frenchmakers/vauban3d-xl/1420-14 Accesoire/2013_08_Men-at-Lunch-1.jpg

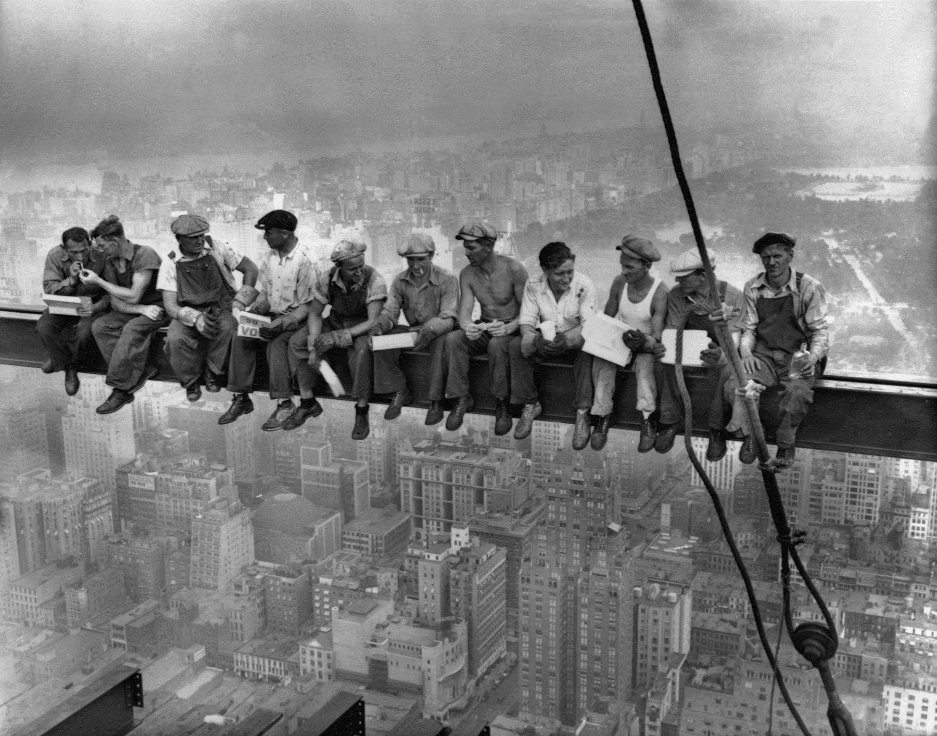
1420-14 Accesoire/2013_08_Men-at-Lunch-1.jpg
