frenchmakers/vauban3d-xl/README.md

# vauban3d-xl
Imprimante 3D Vauban 3D XL
