frenchmakers/vauban3d-xl/1420-91 Gabarits/frenchmakers_noir_blanc.png

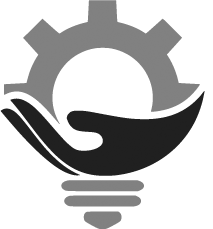
1420-91 Gabarits/frenchmakers_noir_blanc.png
