frenchmakers/vauban3d-xl/Rendu/1420-00 Vauban 3D XL_fond_noir.png

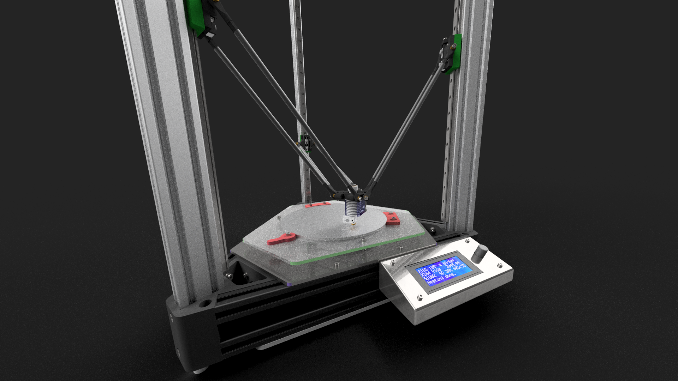
Rendu/1420-00 Vauban 3D XL_fond_noir.png
