frenchmakers/vauban3d-xl/Rendu/1420-00-00 Vauban 3D XL9.png

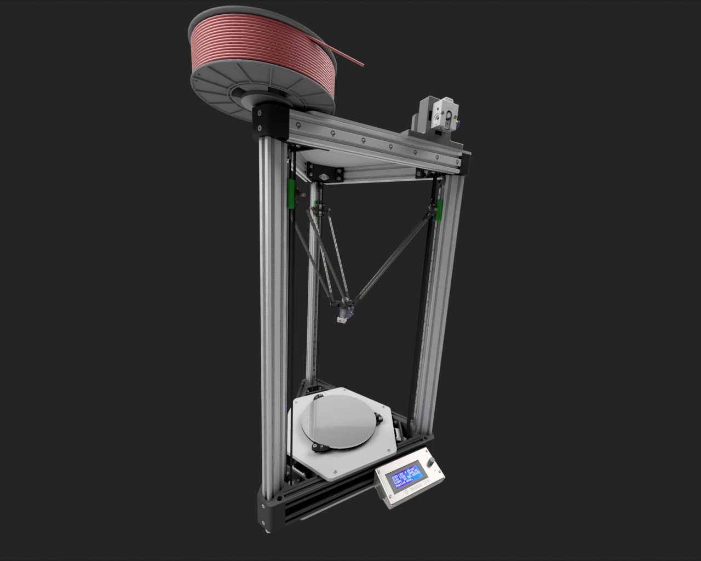
Rendu/1420-00-00 Vauban 3D XL9.png
