frenchmakers/vauban3d-xl/1420-01 Armature/Nomenclature.xlsx

ARTICLE | QTE | NUMERO DE PIECE | MATIERE
 | 85 | ANSI B18.3.1M - M3x0,5 x 8 | ----------
 | 48 | DIN 125 - A 5,3 | ----------
 | 48 | ANSI B18.3.1M - M5x0,8 x 12 | ----------
 | 6 | ANSI B18.3.1M - M5x0,8 x 25 | ----------
 | 12 | DIN 7991 - M4x10 | ----------
 | 49 | ANSI B18.3.1M - M3x0,5 x 10 | ----------
 | 18 | DIN 125 - A 3,2 | ----------
 | 1 | ANSI B18.3.1M - M5x0,8 x 30 | ----------
 | 3 | ANSI B18.3.1M - M3x0,5 x 30 | ----------
 | 9 | ISO 7380-1 - M3 x 8 | ----------
 | 7 | DIN 934 - M3 | ----------
 | 4 | ANSI B18.3.1M - M3x0,5 x 16 | ----------
 | 4 | ANSI B18.3.1M - M3x0,5 x 20 | ----------
 | 2 | ANSI B18.3.1M - M5x0,8 x 20 | ----------
 | 6 | DIN 963 - M3 x 8 | ----------
 | 6 | DIN 7985 (H) - M3x12-H | ----------
 | 2 | ANSI B18.3.1M - M3x0,5 x 6 | ----------
 | 1 | DIN 985 - M3 | ----------
1420-01-01 | 3 | Profile vertical 20x40x750 | Aluminium
1420-01-02 | 3 | Profile horizontal 20x40x360 | Aluminium
1420-01-03 | 6 | Profile horizontal 20x20x360 | Aluminium
1420-01-09 | 3 | Pied | Aluminium
1420-01-11 | 95 | Noix M3 | Aluminium
1420-01-12 | 12 | Noix M4 | Aluminium
1420-01-13 | 48 | Noix M5 | Aluminium
1420-01-05 | 3 | Coins inferieur | Aluminium
1420-01-15 | 3 | Coins superieur | Aluminium
1420-02-01 | 1 | Efflector | Aluminium
1420-02-02 | 1 | Support ventillateur E3D | Plastique ABS
1420-02-03 | 1 | Plaque superieur | Plastique PMMA
1420-02-03 | 1 | Ventilateur 30x30x10 | ----------
1420-02-04 | 6 | Rotule | Laiton, jaune doux
1420-02-20 | 1 | Buse E3D V6 | ----------
1420-03-01 | 1 | Entretoise | Plastique ABS
1420-03-02 | 1 | Support | Plastique ABS
1420-03-03 | 1 | Adapteur | Plastique ABS
1420-03-04 | 1 | Roulement a bille 608ZZ | Acier inoxydable
1420-04-01 | 1 | Plateau metalique | Aluminium
1420-04-02 | 1 | Plateau verre D200 | Miroir
1420-04-02 | 1 | Plexiglass | Plastique PMMA
1420-04-04 | 2 | Bloque plateau | Plastique ABS
1420-04-04 | 1 | Came | Plastique ABS
1420-04-06 | 3 | Ressort | Acier
1420-05-01 | 1 | Support moteur | Plastique ABS
1420-06-01 | 3 | Support capteur | Plastique ABS
1420-06-02 | 3 | Endstop | ----------
1420-07-01 | 1 | Plaque bas | Plastique PMMA
1420-07-02 | 3 | Support carte electronique | Plastique ABS
1420-08-01 | 1 | Boitier | Aluminium
1420-08-02 | 1 | Ecran LCD | ----------
1420-09-01 | 1 | Plug alimentation | ----------
1420-09-02 | 1 | Prise USB | ----------
1420-09-03 | 1 | Ecrou plug alimentation | ----------
1420-09-04 | 1 | Support connectique | Plastique ABS
1420-10-01 | 6 | Bras | Carbonne
1420-10-02 | 12 | Support rotule | Plastique ABS
1420-10-03 | 6 | Rotule avec meplat | Laiton, jaune doux
1420-11-10 | 1 | Arduino MEGA2650 | ----------
1420-11-20 | 1 | Ramps 1.4 | ----------
1420-11-40 | 4 | Stepper driver | ----------
1420-11-40 | 3 | Moteur Nema 17 | ----------
1420-12-01 | 3 | Rail | Acier
1420-12-02 | 3 | Cage à bille | ----------
1420-12-04 | 3 | Platine | Aluminium
1420-12-05 | 6 | Tendeur | Aluminium
1420-12-06 | 6 | Contre rondelle | Aluminium
1420-20-03 | 3 | Courroie synchrone | Caoutchouc
1720-14-02 | 1 | Bobine | Plastique ABS
1420-05-10 | 1 | Bulldog Feeder | ----------
1420-01-10 | 3 | Poulie | Aluminium
