frenchmakers/vauban3d-xl/1420-01 Armature/Logo_fablab.stp

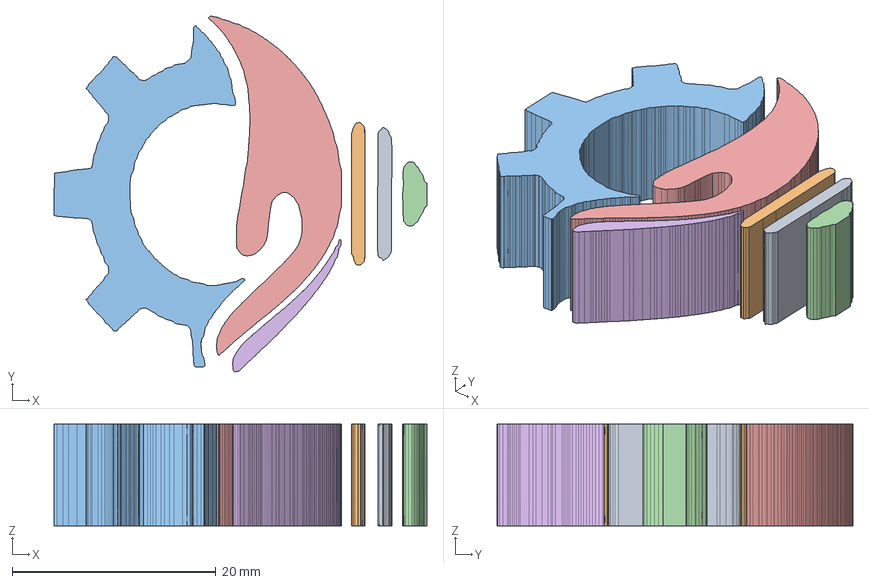
[picture p7: CAD file, 2017-04-20]
1420-01 Armature/Logo_fablab.stp
36.7 x 35.0 x 10.0 mm
