frenchmakers/vauban3d-xl/1420-02 Tete/1420-02-00 Tete.stp

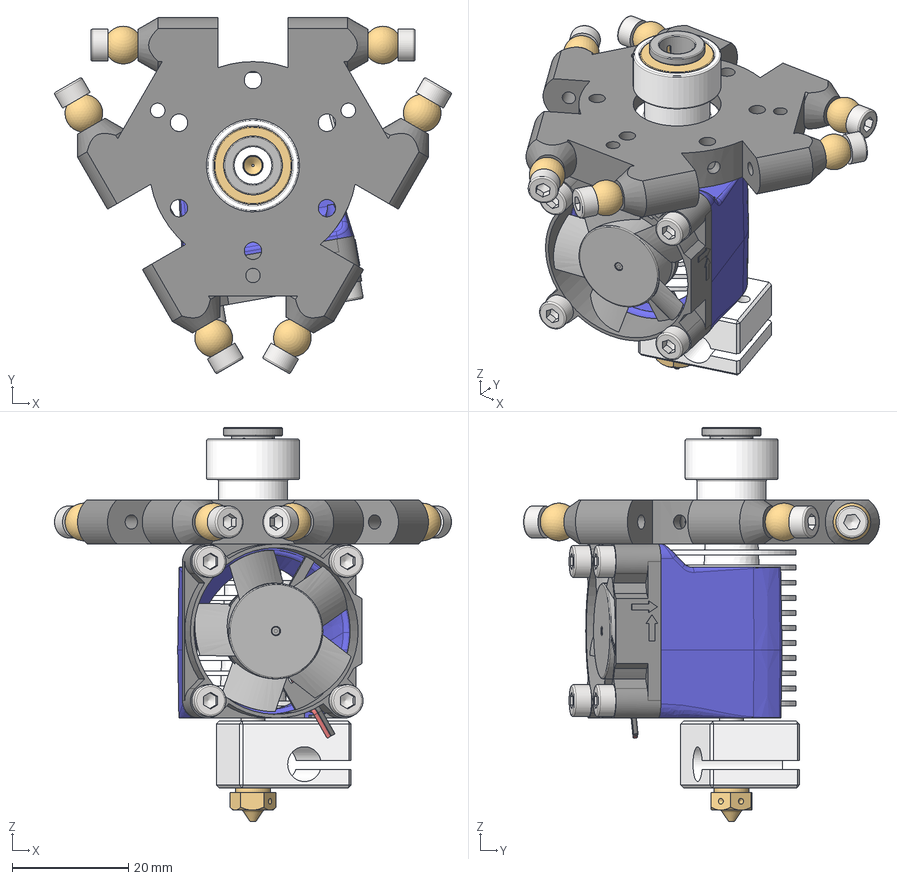
[picture p8: CAD file, 2017-04-20]
1420-02 Tete/1420-02-00 Tete.stp
68.4 x 61.3 x 68.0 mm
Base
Vis
bloque_chauffe
Buse_04
Bague-laiton
clip
Efflector
ANSI B18.3.1M - M3x0,5 x 10 x 10
Rotule x 6
Support ventillateur E3D
Ventilateur 30x30x10
