frenchmakers/vauban3d-xl/1420-13 Layer fan/Support_layer_fan.stl

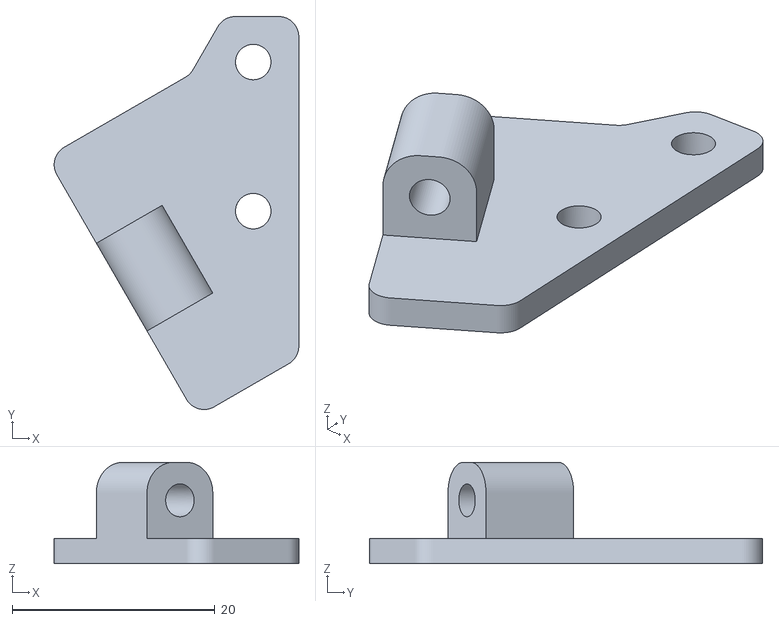
[picture p9: CAD file, 2017-04-20]
1420-13 Layer fan/Support_layer_fan.stl
24.2 x 38.8 x 10.0
