frenchmakers/vauban3d-xl/1420-50 Plateau pour cura/1420-50-01 Plateau pour cura.stl

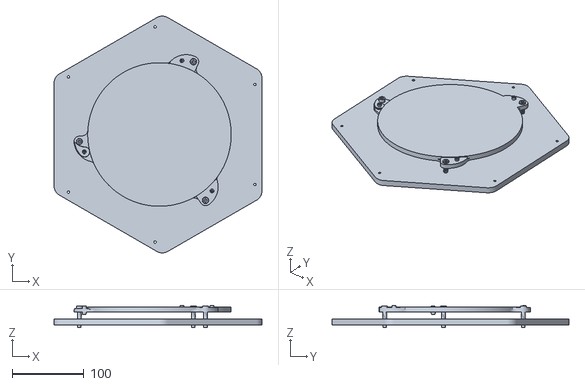
[picture p10: CAD file, 2017-04-20]
1420-50 Plateau pour cura/1420-50-01 Plateau pour cura.stl
289.9 x 330.1 x 31.1
