frenchmakers/vauban3d-xl/Piece imprime/1420-06-01 Support capteur.stl

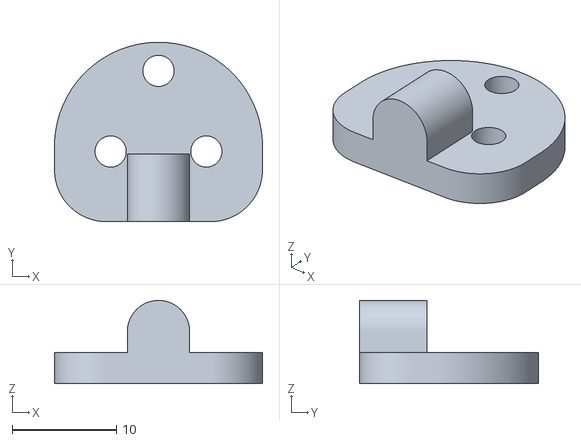
[picture p11: CAD file, 2017-04-20]
Piece imprime/1420-06-01 Support capteur.stl
20.0 x 17.2 x 8.00
