frenchmakers/vauban3d-xl/1420-13 Layer fan/Support_ventillateur.stl

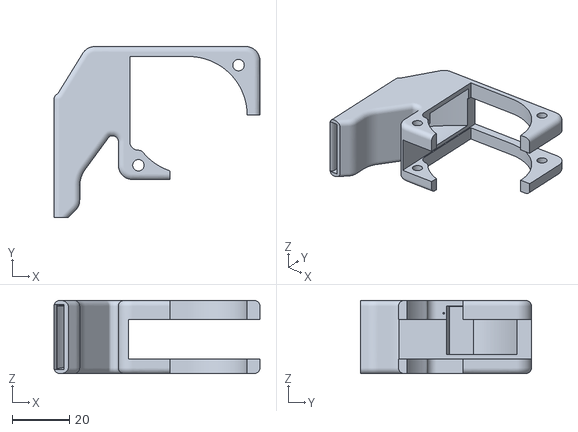
[picture p12: CAD file, 2017-04-20]
1420-13 Layer fan/Support_ventillateur.stl
72.0 x 59.8 x 25.6
