frenchmakers/vauban3d-xl/Piece imprime/1420-03-03 Adapteur.stl

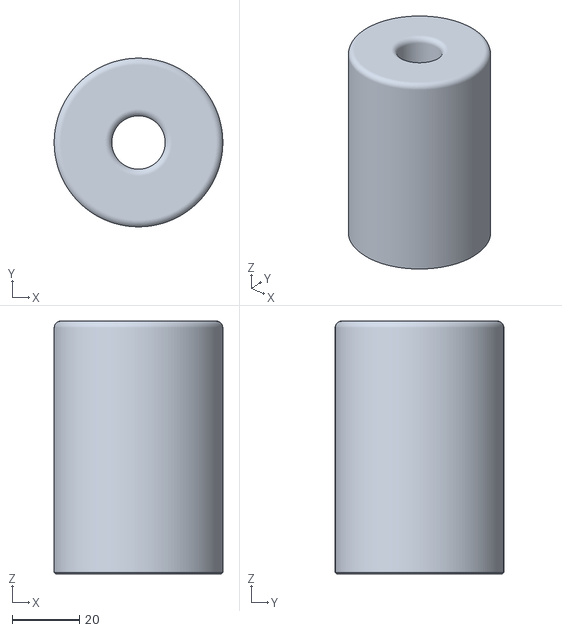
[picture p13: CAD file, 2017-04-20]
Piece imprime/1420-03-03 Adapteur.stl
50.0 x 50.0 x 75.0
