frenchmakers/vauban3d-xl/1420-13 Layer fan/bras_layer_fan.stl

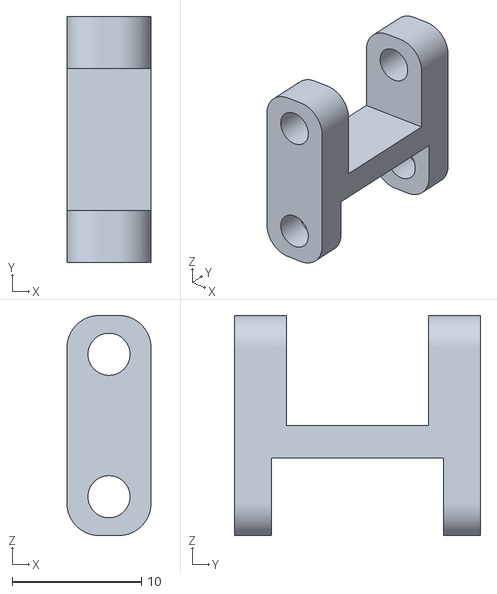
[picture p14: CAD file, 2017-04-20]
1420-13 Layer fan/bras_layer_fan.stl
6.50 x 19.0 x 17.0
