frenchmakers/vauban3d-xl/Piece imprime/1420-05-01 Support moteur.stl

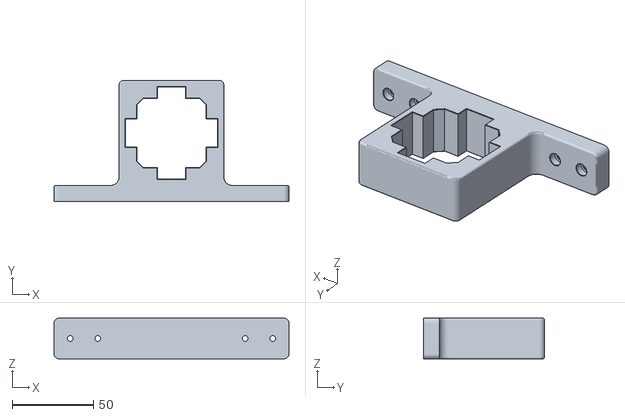
[picture p15: CAD file, 2017-04-20]
Piece imprime/1420-05-01 Support moteur.stl
144.6 x 74.6 x 25.0
