frenchmakers/vauban3d-xl/Piece imprime/1420-03-02 Support.stl

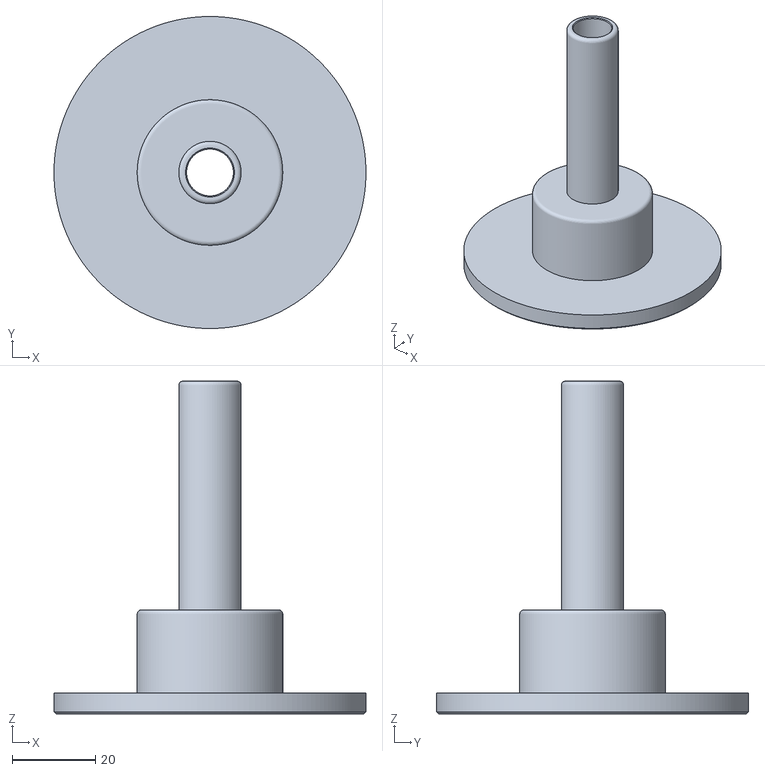
[picture p16: CAD file, 2017-04-20]
Piece imprime/1420-03-02 Support.stl
75.0 x 75.0 x 80.0
