frenchmakers/vauban3d-xl/Piece imprime/1420-07-02 Support carte electronique.stl

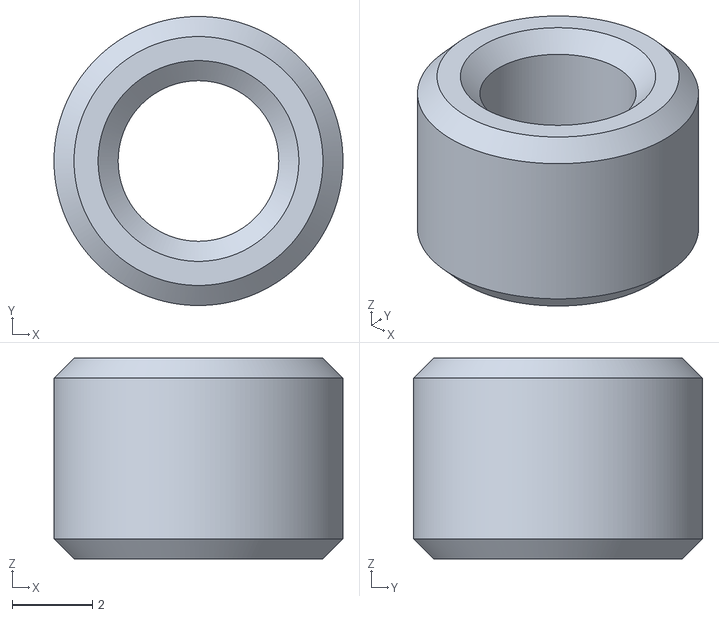
[picture p17: CAD file, 2017-04-20]
Piece imprime/1420-07-02 Support carte electronique.stl
7.20 x 7.20 x 5.00
