frenchmakers/vauban3d-xl/Piece imprime/1420-03-01 Entretoise.stl

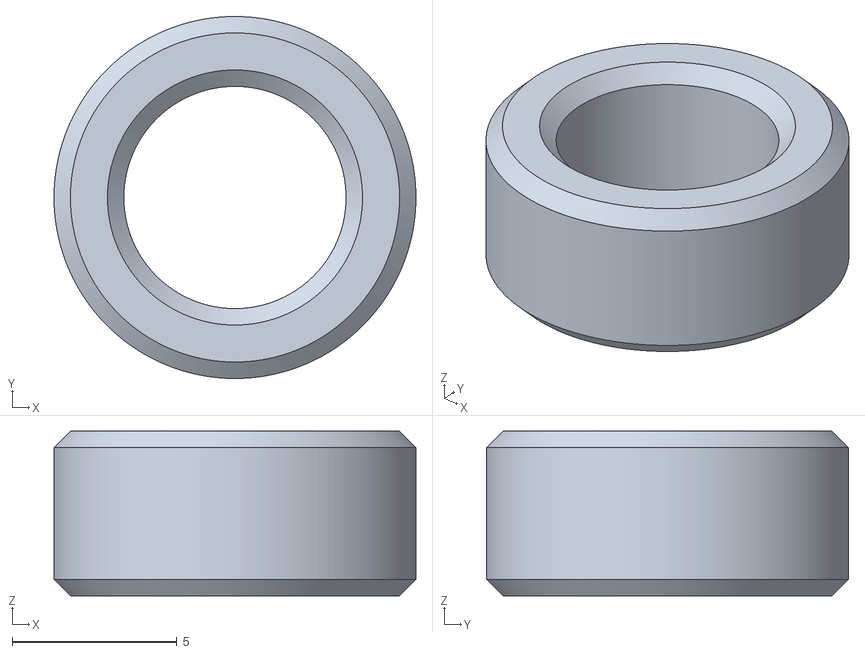
[picture p18: CAD file, 2017-04-20]
Piece imprime/1420-03-01 Entretoise.stl
11.0 x 11.0 x 5.00
