frenchmakers/vauban3d-xl/(list of files, cad)

Other CAD files:
1420 Notice de montage/1420 Vauban 3D XL Nomenclature.idw
1420 Notice de montage/1420-50 Armature/1420-50 Armature.ipn
1420 Notice de montage/1420-50 Armature/1420-50-01 Coins inferieur.ipn
1420 Notice de montage/1420-50 Armature/1420-50-02 Coins superieur.ipn
1420 Notice de montage/1420-52 Electronique/1420-52-00 Electronique.ipn
1420 Notice de montage/1420-53 Guidage/1420-53 Guidage.ipn
1420 Notice de montage/1420-53 Guidage/1420-53-01 Tendeur.ipn
1420 Notice de montage/1420-54 Plateau/1420-54 Plateau.ipn
1420 Notice de montage/1420-55 Tete/1420-55 Tete.idw
1420 Notice de montage/1420-55 Tete/1420-55 tete.ipn
1420 Notice de montage/1420-55 Tete/1420-55-01 Bras.ipn
1420 Notice de montage/1420-57 Finition/1420-57 Finition.ipn
1420-01 Armature/1420-01-00 Armature.iam
1420-01 Armature/1420-01-01 Profile vertical 20x40x750.ipt
1420-01 Armature/1420-01-02 Profile horizontal 20x40x360.ipt
1420-01 Armature/1420-01-03 Profile horizontal 20x20x360.ipt
1420-01 Armature/1420-01-04 Coins superieur.ipt
1420-01 Armature/1420-01-05 Coins inferieur.ipt
1420-01 Armature/1420-01-06 Roulement a bille F623ZZ.ipt
1420-01 Armature/1420-01-07 Axe de renvoie.ipt
1420-01 Armature/1420-01-08 Maintient roulement.ipt
1420-01 Armature/1420-01-09 Pied.ipt
1420-01 Armature/1420-01-10 Poulie.ipt
1420-01 Armature/1420-01-11 Noix M3.ipt
1420-01 Armature/1420-01-12 Noix M4.ipt
1420-01 Armature/1420-01-13 Noix M5.ipt
1420-01 Armature/1420-01-14 Coins inferieur.iam
1420-01 Armature/1420-01-15 Coins superieur.iam
1420-02 Tete/1420-02-00 Tete.iam
1420-02 Tete/1420-02-01 Efflector.ipt
1420-02 Tete/1420-02-02 Support ventillateur E3D.ipt
1420-02 Tete/1420-02-03 Ventilateur 30x30.ipt
1420-02 Tete/1420-02-04 Rotule.ipt
1420-02 Tete/Buse_E3D_V6/1420-02-20 Buse E3d V6.iam
1420-02 Tete/Buse_E3D_V6/1420-02-21 Buse 04.ipt
1420-02 Tete/Buse_E3D_V6/1420-02-22 Bloque de chauffe.ipt
1420-02 Tete/Buse_E3D_V6/1420-02-23 Vis de raccord.ipt
1420-02 Tete/Buse_E3D_V6/1420-02-24 Base.ipt
1420-02 Tete/Buse_E3D_V6/1420-02-25 Bague.ipt
1420-02 Tete/Buse_E3D_V6/1420-02-26 Clip pneumatique.ipt
1420-03 Support bobine filament/1420-03-00 Support bobine.iam
1420-03 Support bobine filament/1420-03-01 Entretoise.ipt
1420-03 Support bobine filament/1420-03-02 Support.ipt
1420-03 Support bobine filament/1420-03-03 Adapteur.ipt
1420-03 Support bobine filament/1420-03-04 Roulement a bille 608ZZ.ipt
1420-04 Plateau/1420-04-00 Plateau.iam
1420-04 Plateau/1420-04-01 Plateau metalique.ipt
1420-04 Plateau/1420-04-02 Plexiglass.ipt
1420-04 Plateau/1420-04-03 Plateau verre D200.ipt
1420-04 Plateau/1420-04-04 Bloque plateau.ipt
1420-04 Plateau/1420-04-04 Came.ipt
1420-04 Plateau/1420-04-06 Ressort.ipt
1420-05 Feeder/1420-05-01 Support moteur.ipt
1420-05 Feeder/1420-05-10 Bulldog feeder.iam
1420-05 Feeder/1420-05-10 Feeder.iam
1420-05 Feeder/1420-05-11 Reducteur.ipt
1420-05 Feeder/1420-05-12 Cache reducteur.ipt
1420-05 Feeder/1420-05-13 Roue dente.ipt
1420-05 Feeder/1420-05-14 Support coulisse.ipt
1420-05 Feeder/1420-05-15 Coulisse.ipt
1420-05 Feeder/1420-05-16 Plaque de maintient.ipt
1420-05 Feeder/1420-05-17 Roulement a bille 634ZZ.ipt
1420-05 Feeder/1420-05-18 Ressort.ipt
1420-05 Feeder/1420-05-19 Clip pneumatique.ipt
1420-05 Feeder/1420-05-20 Nema 17 H30.ipt
1420-05 Feeder/1420-05-21 M5 pour ressort.ipt
1420-06 Endstop/1420-06-00 Endstop.iam
1420-06 Endstop/1420-06-01 Support capteur.ipt
1420-06 Endstop/1420-06-02 Endstop.ipt
1420-07 Plaque/1420-07-01 Plaque inferieur.ipt
1420-07 Plaque/1420-07-02 Support carte electronique.ipt
1420-08 Ecran/1420-08-00 Ecran.iam
1420-08 Ecran/1420-08-01 Boitier tole.ipt
1420-08 Ecran/1420-08-02 Ecran LCD.ipt
1420-08 Ecran/1420-08-03 Carte SD.ipt
1420-09 Connectique/1420-09-00 Connectique.iam
1420-09 Connectique/1420-09-01 Plug alimentation.ipt
1420-09 Connectique/1420-09-02 Prise USB.ipt
1420-09 Connectique/1420-09-03 Ecrou plug alimentation.ipt
1420-09 Connectique/1420-09-04 Support connectique.ipt
1420-09 Connectique/1420-09-10 Bouton/1420-09-03 Bouton.iam
1420-09 Connectique/1420-09-10 Bouton/Base.ipt
1420-09 Connectique/1420-09-10 Bouton/InteriorSw.ipt
1420-09 Connectique/1420-09-10 Bouton/Pieza2.ipt
1420-09 Connectique/1420-09-10 Bouton/Polo2.ipt
1420-09 Connectique/1420-09-10 Bouton/Sw.ipt
1420-10 Bras/1420-10-00 Bras.iam
1420-10 Bras/1420-10-01 Bras.ipt
1420-10 Bras/1420-10-02 Support rotule.ipt
1420-10 Bras/1420-10-03 Rotule avec meplat.ipt
1420-10 Bras/1420-10-04 Rotule simple.ipt
1420-11 Electronique/1420-11-01 Nema 17/1420-11-40 Nema 17.iam
1420-11 Electronique/1420-11-01 Nema 17/1420-11-41 Base.ipt
1420-11 Electronique/1420-11-01 Nema 17/1420-11-42 Body.ipt
1420-11 Electronique/1420-11-01 Nema 17/1420-11-43 Top.ipt
1420-11 Electronique/1420-11-01 Nema 17/1420-11-44 Shaft.ipt
1420-11 Electronique/1420-11-10 Arduino/10 PORT HEADER.ipt
1420-11 Electronique/1420-11-10 Arduino/102 RESISTOR PACK.ipt
1420-11 Electronique/1420-11-10 Arduino/103 RESISTOR PACK.ipt
1420-11 Electronique/1420-11-10 Arduino/1420-11-10 Arduino Mega.iam
1420-11 Electronique/1420-11-10 Arduino/16mhz crystal - measured.ipt
1420-11 Electronique/1420-11-10 Arduino/18 X 2 ROW HEADER.ipt
1420-11 Electronique/1420-11-10 Arduino/220 RESISTOR PACK.ipt
1420-11 Electronique/1420-11-10 Arduino/2pin_header__02.ipt
1420-11 Electronique/1420-11-10 Arduino/47uf CAP Dcase.ipt
1420-11 Electronique/1420-11-10 Arduino/603 cap on pad.ipt
1420-11 Electronique/1420-11-10 Arduino/603 resistor.ipt
1420-11 Electronique/1420-11-10 Arduino/8 PORT HEADER.ipt
1420-11 Electronique/1420-11-10 Arduino/MEGAboard.ipt
1420-11 Electronique/1420-11-10 Arduino/MLC0603.ipt
1420-11 Electronique/1420-11-10 Arduino/PADS001.ipt
1420-11 Electronique/1420-11-10 Arduino/RESET BUTTON.iam
1420-11 Electronique/1420-11-10 Arduino/RESET CORE.ipt
1420-11 Electronique/1420-11-10 Arduino/RESET.ipt
1420-11 Electronique/1420-11-10 Arduino/USB SHELL.ipt
1420-11 Electronique/1420-11-10 Arduino/USB core.ipt
1420-11 Electronique/1420-11-10 Arduino/USB type b.SLDPRT.iam
1420-11 Electronique/1420-11-10 Arduino/atmega16u2.ipt
1420-11 Electronique/1420-11-10 Arduino/atmega2650-16AU.ipt
1420-11 Electronique/1420-11-10 Arduino/blm21.ipt
1420-11 Electronique/1420-11-10 Arduino/cd1206 diode.ipt
1420-11 Electronique/1420-11-10 Arduino/crystal.ipt
1420-11 Electronique/1420-11-10 Arduino/led.ipt
1420-11 Electronique/1420-11-10 Arduino/lmv358.ipt
1420-11 Electronique/1420-11-10 Arduino/lp2985dgkr.ipt
1420-11 Electronique/1420-11-10 Arduino/m7 diode.ipt
1420-11 Electronique/1420-11-10 Arduino/mf-msmf050-2.ipt
1420-11 Electronique/1420-11-10 Arduino/power jack.ipt
1420-11 Electronique/1420-11-10 Arduino/reg.ipt
1420-11 Electronique/1420-11-10 Arduino/ssot3.ipt
1420-11 Electronique/1420-11-10 Arduino/usb btm contact.ipt
1420-11 Electronique/1420-11-10 Arduino/usb top contact.ipt
1420-11 Electronique/1420-11-20 Ramps/1420-11-20 Ramps 1.4.iam
1420-11 Electronique/1420-11-20 Ramps/RAMPS1_4.ipt
1420-11 Electronique/1420-11-20 Ramps/User Library-APA3010GCCK_GREEN.ipt
1420-11 Electronique/1420-11-20 Ramps/User Library-APA3010GCCK_RED.ipt
1420-11 Electronique/1420-11-20 Ramps/User Library-CAPSMD4x3_9.iam
1420-11 Electronique/1420-11-20 Ramps/User Library-CAPSMD4x3_9_CAPSMD4x3_9.ipt
1420-11 Electronique/1420-11-20 Ramps/User Library-CAPSMD4x3_9_CAPSMD4x3_9001.ipt
1420-11 Electronique/1420-11-20 Ramps/User Library-CAPSMD4x3_9_CAPSMD4x3_9002.ipt
1420-11 Electronique/1420-11-20 Ramps/User Library-CAPSMD4x3_9_CAPSMD4x3_9003.ipt
1420-11 Electronique/1420-11-20 Ramps/User Library-CAPSMD4x3_9_CAPSMD4x3_9004.ipt
1420-11 Electronique/1420-11-20 Ramps/User Library-CAPSMD6_3x3_9.iam
1420-11 Electronique/1420-11-20 Ramps/User Library-CAPSMD6_3x3_9_CAP.ipt
1420-11 Electronique/1420-11-20 Ramps/User Library-CAPSMD6_3x3_9_CAP001.ipt
1420-11 Electronique/1420-11-20 Ramps/User Library-CAPSMD6_3x3_9_CAP002.ipt
1420-11 Electronique/1420-11-20 Ramps/User Library-CAPSMD6_3x3_9_CAP003.ipt
1420-11 Electronique/1420-11-20 Ramps/User Library-CAPSMD6_3x3_9_CAP004.ipt
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
