frenchmakers/vauban3d-xl/1420 Notice de montage/1420-53 Guidage/1420-53-00 Guidage.pdf

A ( 1 : 1 )

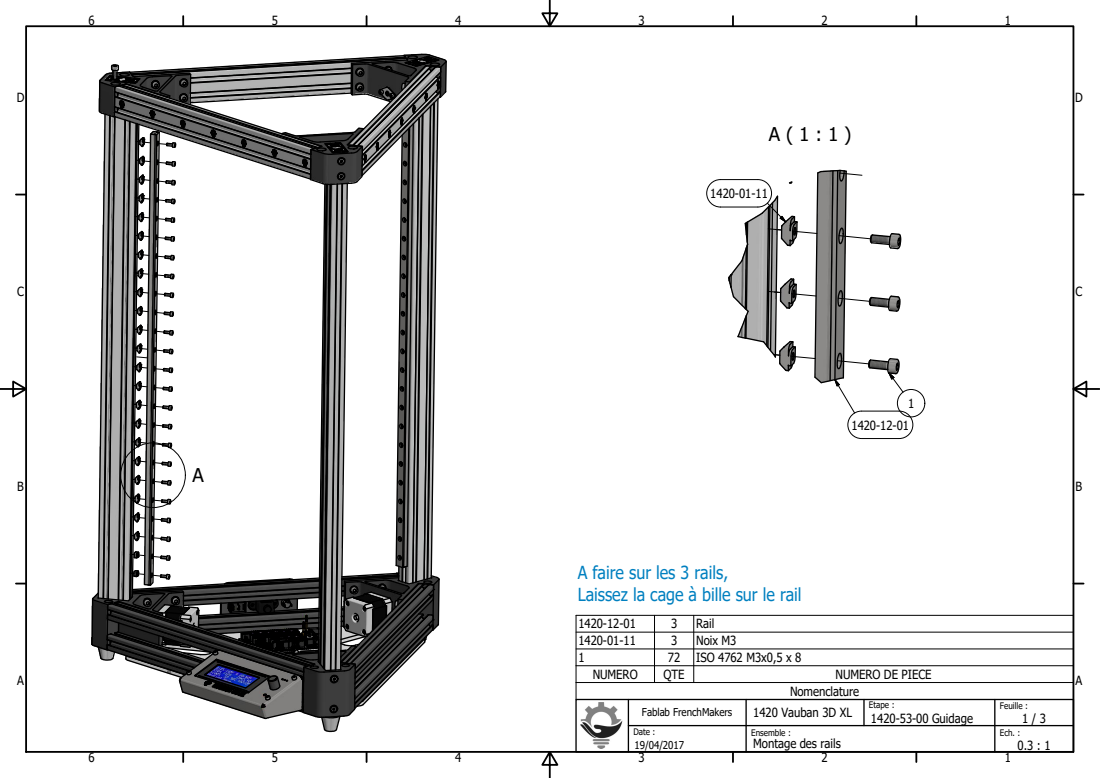
[picture p19: page 1]
Rail; Noix M3; ISO 4762 M3x0,5 x 8; Nomenclature; NUMERO; QTE; NUMERO DE PIECE; 1420 Vauban 3D XL; Ech. : 0.3 : 1; Feuille :; Fablab FrenchMakers; Date :; Etape : 1420-53-00 Guidage

A faire sur les 3 rails,
Laissez la cage j bille sur le rail

Ensemble :
Montage des rails

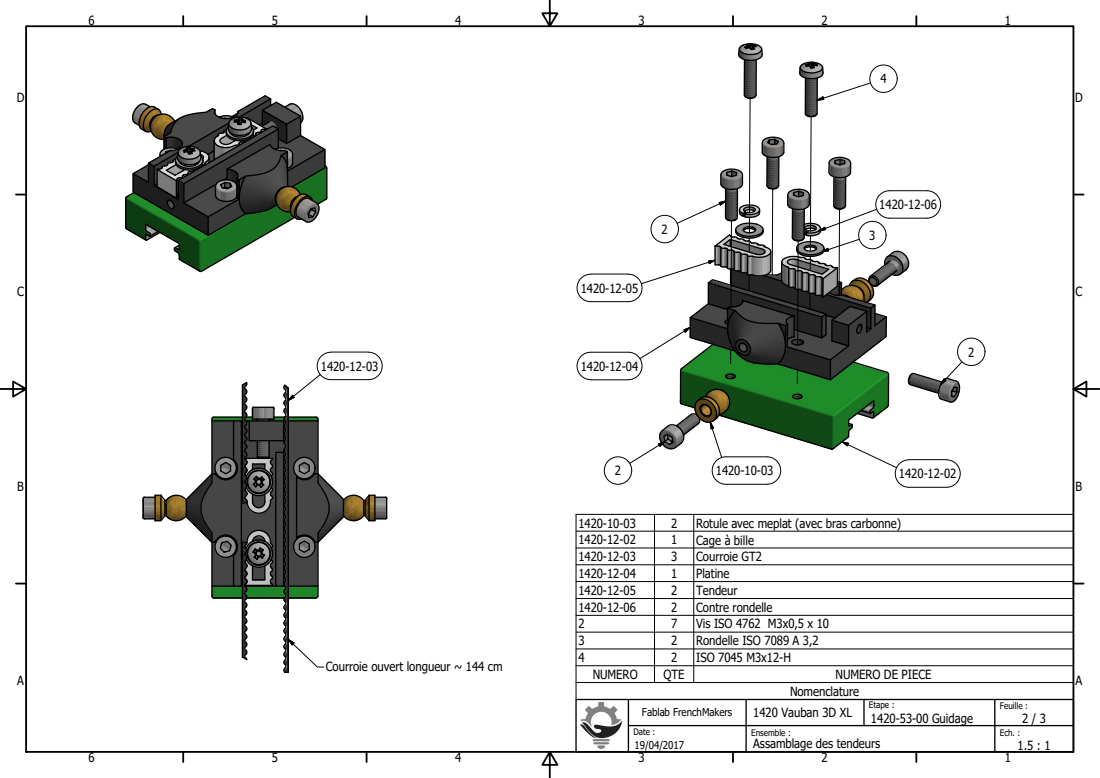
[picture p20: page 2]
Rotule avec meplat (avec bras carbonne); Cage j bille; Courroie GT2; Platine; Tendeur; Contre rondelle; Vis ISO 4762 M3x0,5 x 10; Rondelle ISO 7089 A 3,2; ISO 7045 M3x12-H; Nomenclature; NUMERO; QTE; NUMERO DE PIECE; 1420 Vauban 3D XL; Feuille :; Etape :

Courroie ouvert longueur ~ 144 cm

Assamblage des tendeurs

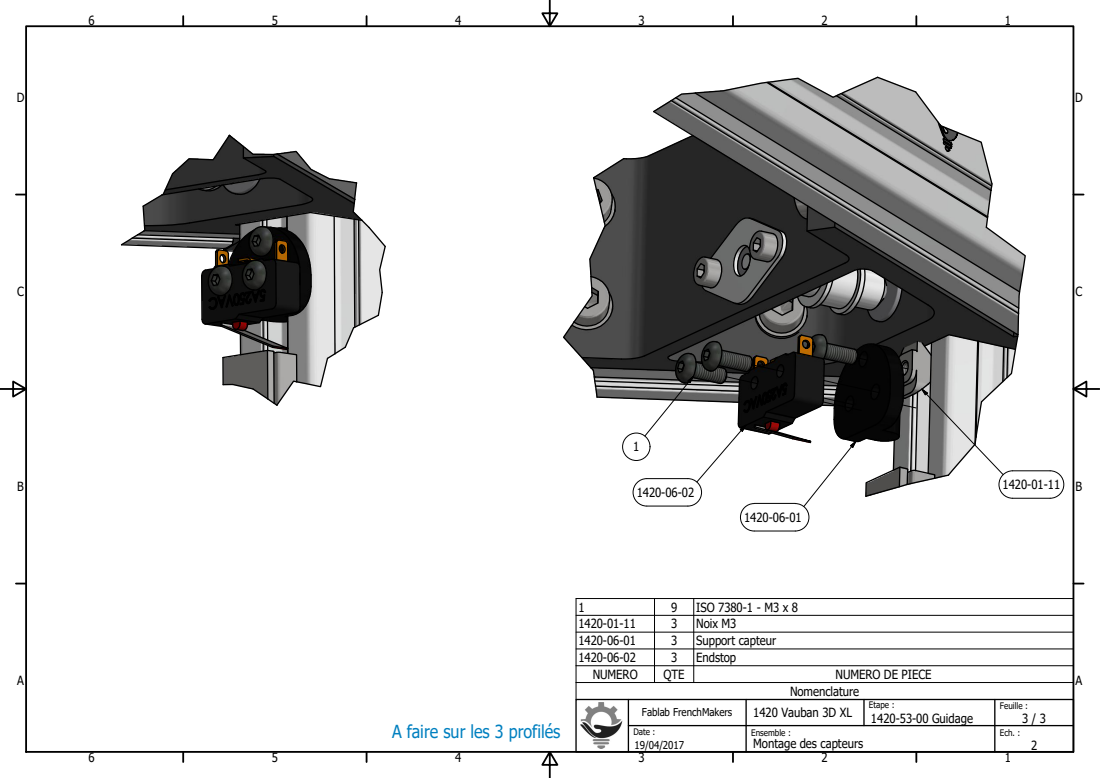
[picture p21: page 3]
ISO 7380-1 - M3 x 8; Noix M3; Support capteur; Endstop; Nomenclature; NUMERO; QTE; NUMERO DE PIECE; 1420 Vauban 3D XL; Feuille :; Etape :

A faire sur les 3 profilps

Montage des capteurs
