frenchmakers/vauban3d-xl/1420 Notice de montage/1420-54 Plateau/1420-54 Plateau.pdf

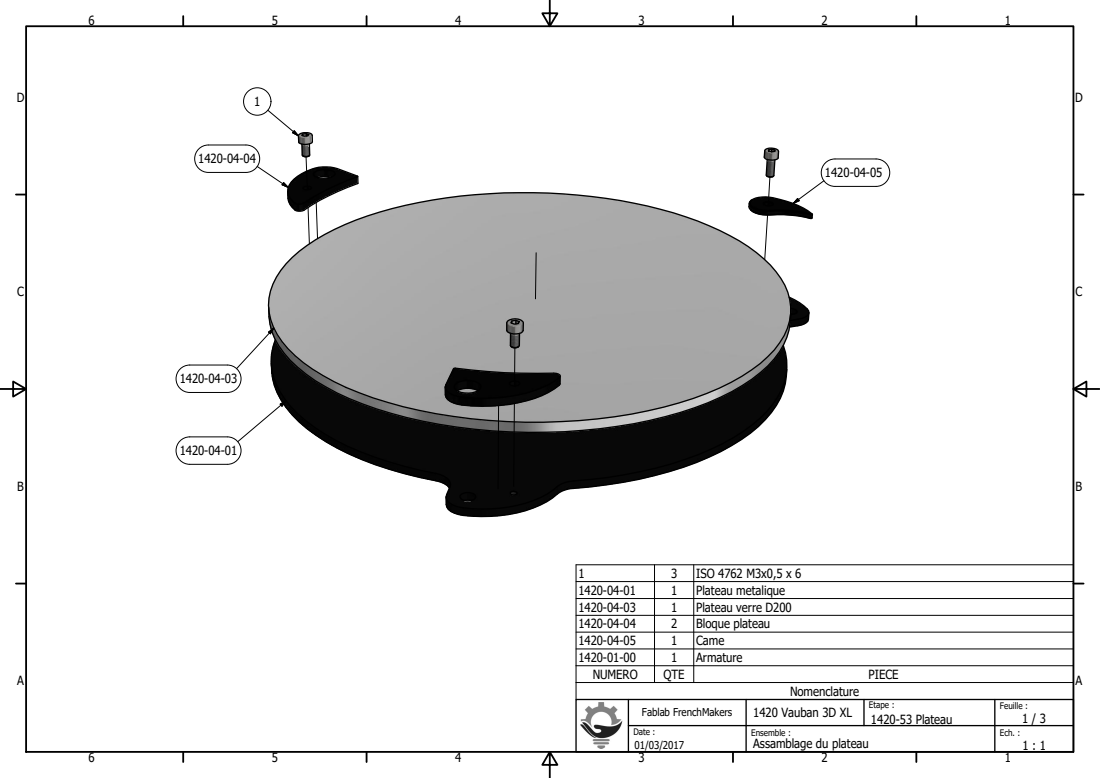
[picture p22: page 1]
ISO 4762 M3x0,5 x 6; Plateau metalique; Plateau verre D200; Bloque plateau; Came; Armature; Nomenclature; NUMERO; QTE; PIECE; 1420 Vauban 3D XL; Ech. :; Feuille :; Fablab FrenchMakers; Date :; Etape : 1420-53 Plateau

Ensemble :
Assamblage du plateau

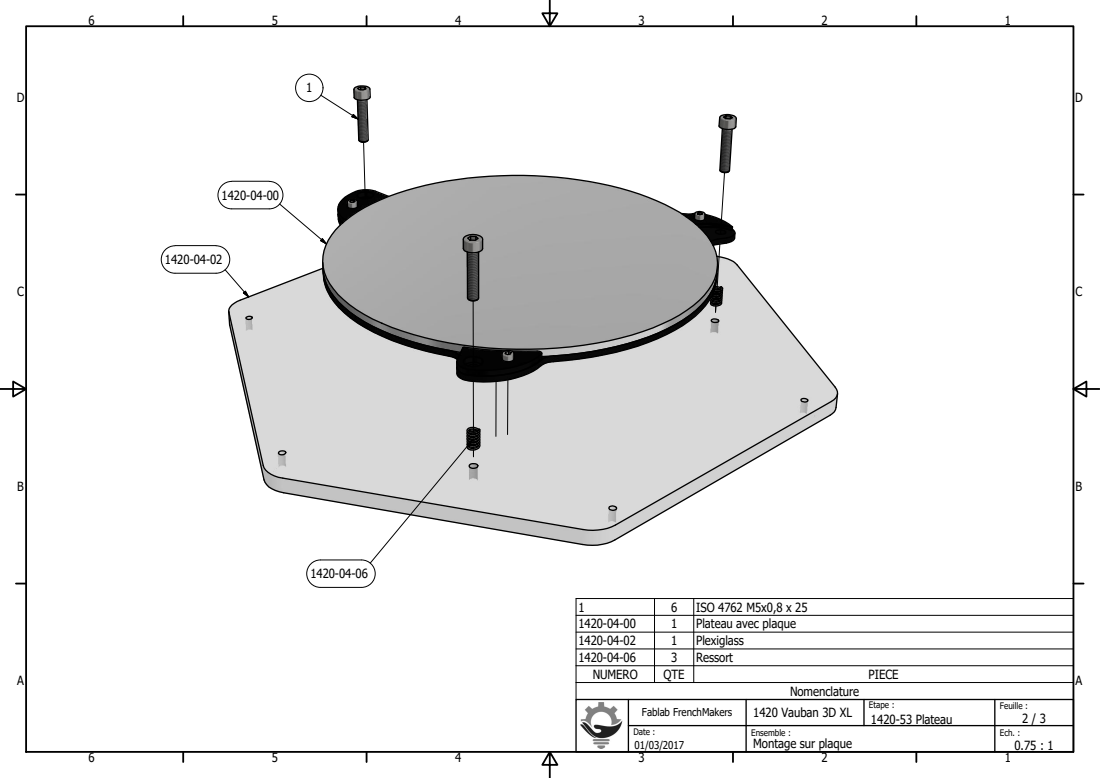
[picture p23: page 2]
ISO 4762 M5x0,8 x 25; Plateau avec plaque; Plexiglass; Ressort; Nomenclature; NUMERO; QTE; PIECE; 1420 Vauban 3D XL; Feuille :; Etape :

Montage sur plaque

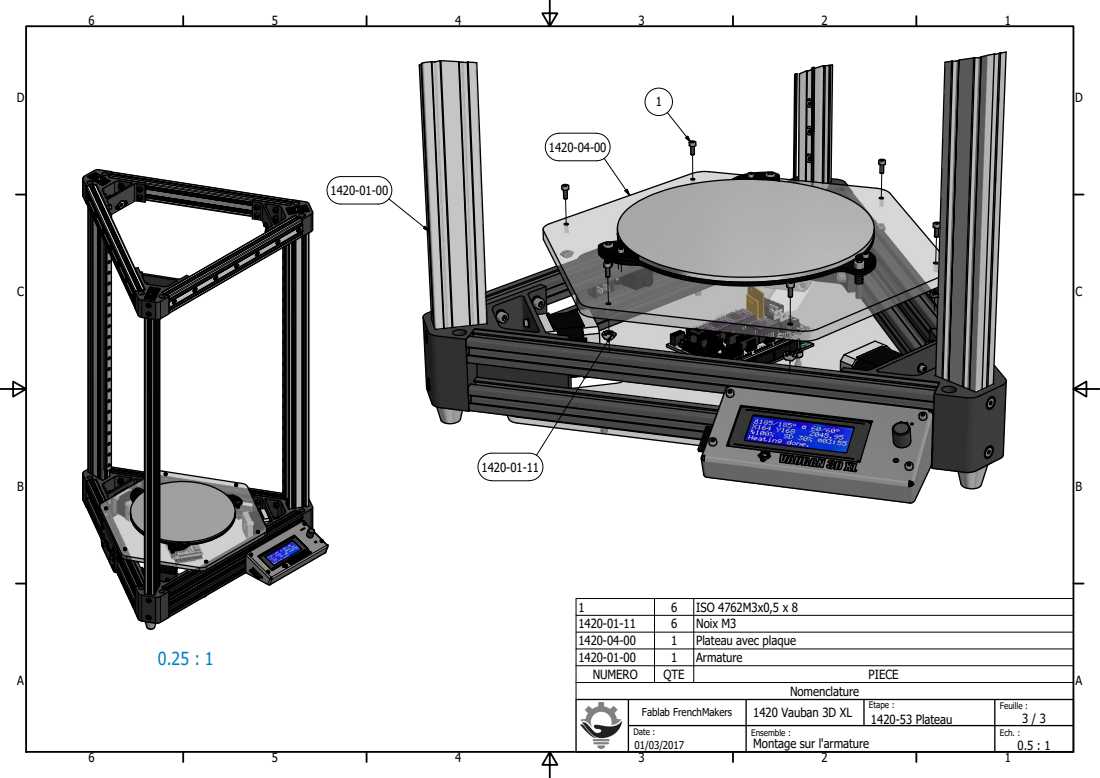
[picture p24: page 3]
ISO 4762M3x0,5 x 8; Noix M3; Plateau avec plaque; Armature; Nomenclature; NUMERO; QTE; PIECE; 1420 Vauban 3D XL; Feuille :; Etape :

Montage sur l'armature
