frenchmakers/vauban3d-xl/1420 Notice de montage/1420 Vauban 3D XL Nomenclature.pdf

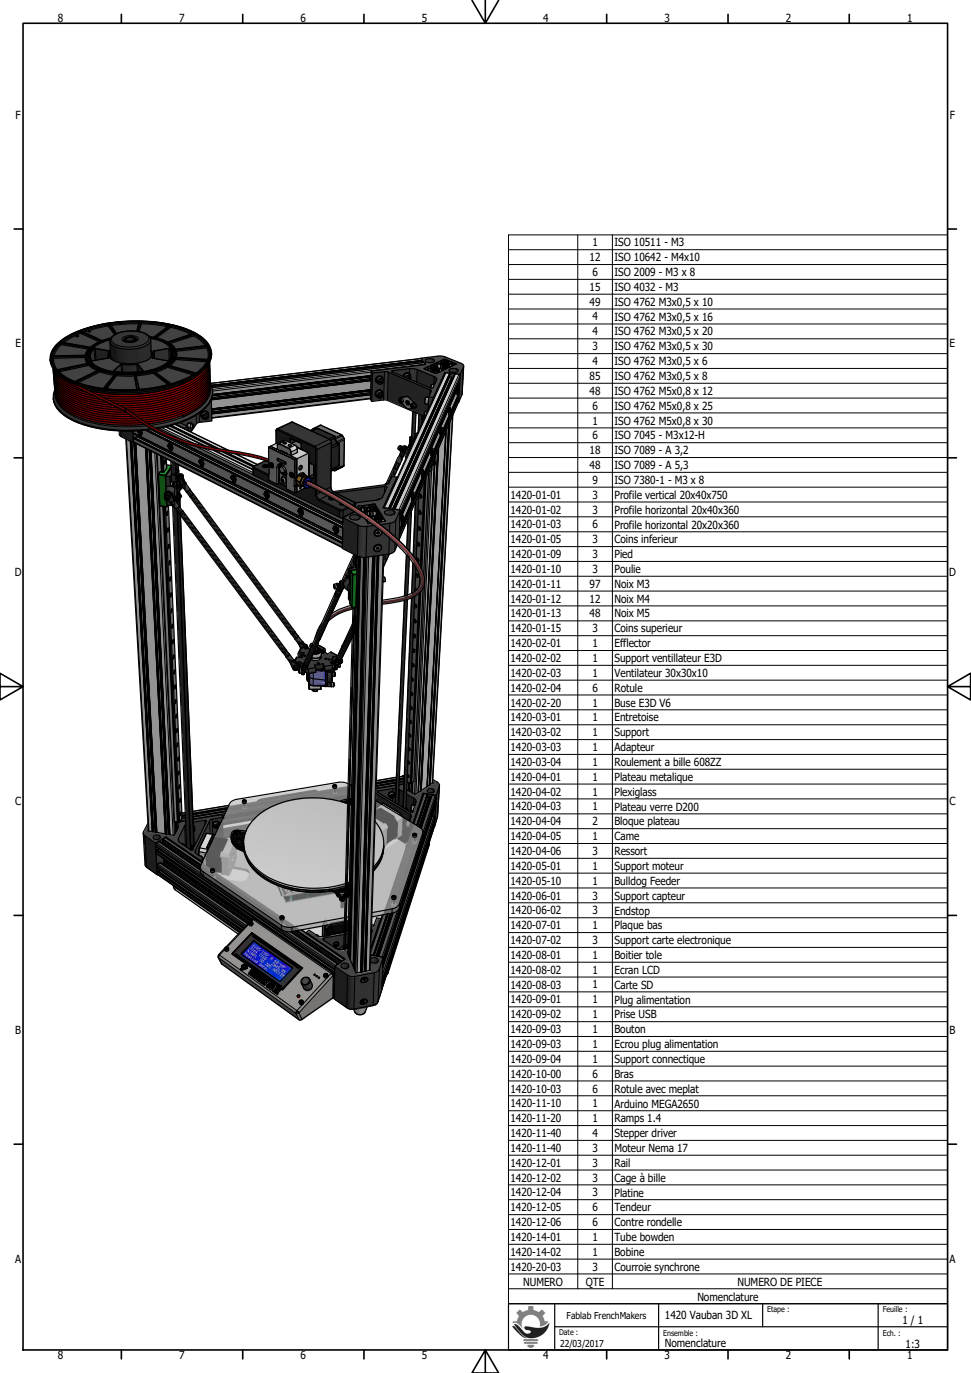
[picture p25: page 1]
file; tic; riz; oin; rie; Pie; ulie; oix; ffle; tilla; tila; ule; ois; bille; Pla; aliq; Ple; xigla; Blo; pla; ulld; ele; niq; oitie; ole; Plu; alim; tio; ris; plu; tiq; uin; riv; ail 1420-12-02; Cag; tin; elle; bin; oie; cla; uille; bla; ble
