frenchmakers/vauban3d-xl/1420 Notice de montage/1420-50 Armature/1420-50 Armature.pdf

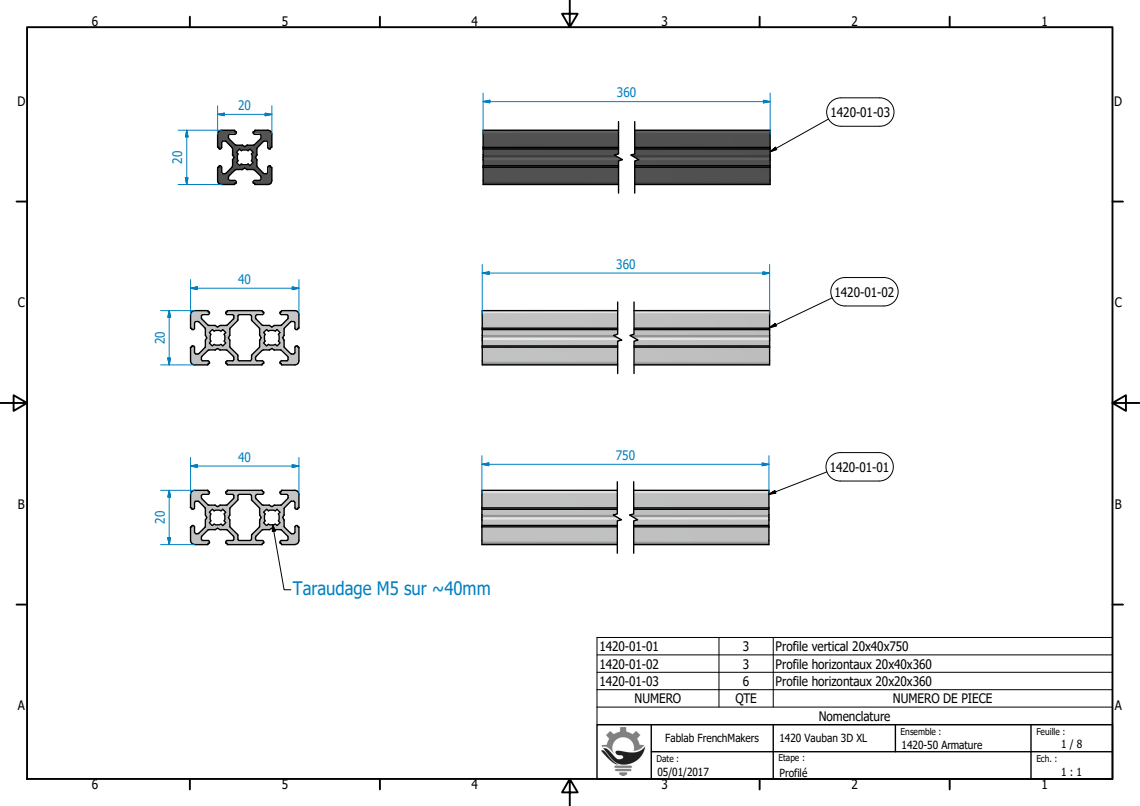
[picture p26: page 1]
Profile vertical 20x40x750; Profile horizontaux 20x40x360; Profile horizontaux 20x20x360; Nomenclature; NUMERO; QTE; NUMERO DE PIECE; 1420 Vauban 3D XL; Ech. :; Feuille :; Fablab FrenchMakers; Date :; Etape : Profilp; Ensemble : 1420-50 Armature; Taraudage M5 sur ~40mm

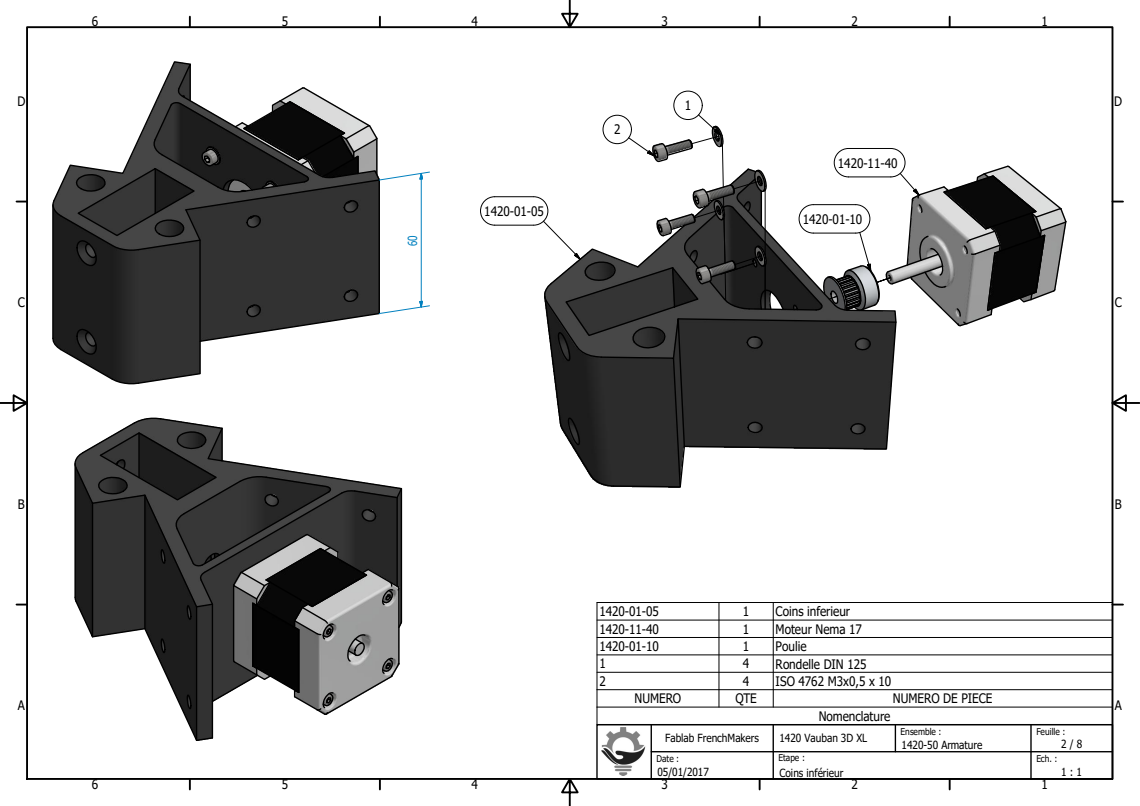
[picture p27: page 2]
Coins inferieur; Moteur Nema 17; Poulie; Rondelle DIN 125; ISO 4762 M3x0,5 x 10; Nomenclature; NUMERO; QTE; NUMERO DE PIECE; Feuille :; Coins infprieur; Ensemble :

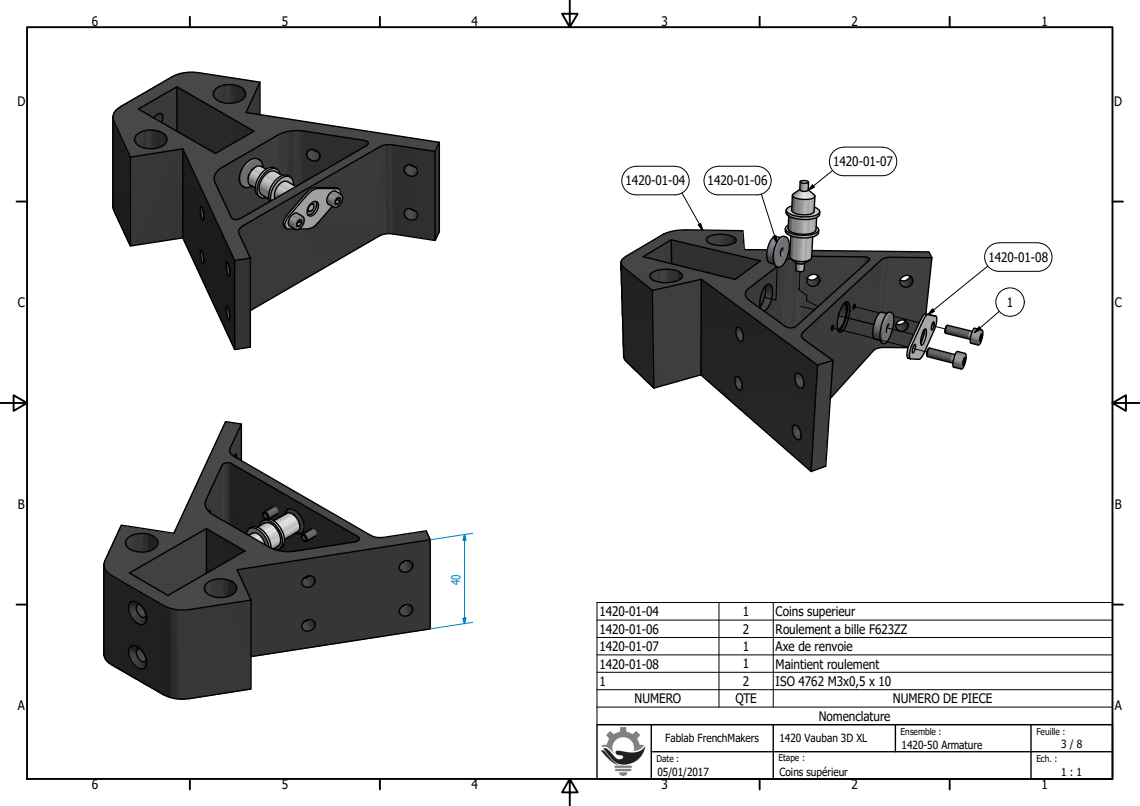
[picture p28: page 3]
Coins superieur; Roulement a bille F623ZZ; Axe de renvoie; Maintient roulement; ISO 4762 M3x0,5 x 10; Nomenclature; NUMERO; QTE; NUMERO DE PIECE; Feuille :; Coins supprieur; Ensemble :

2 : 1

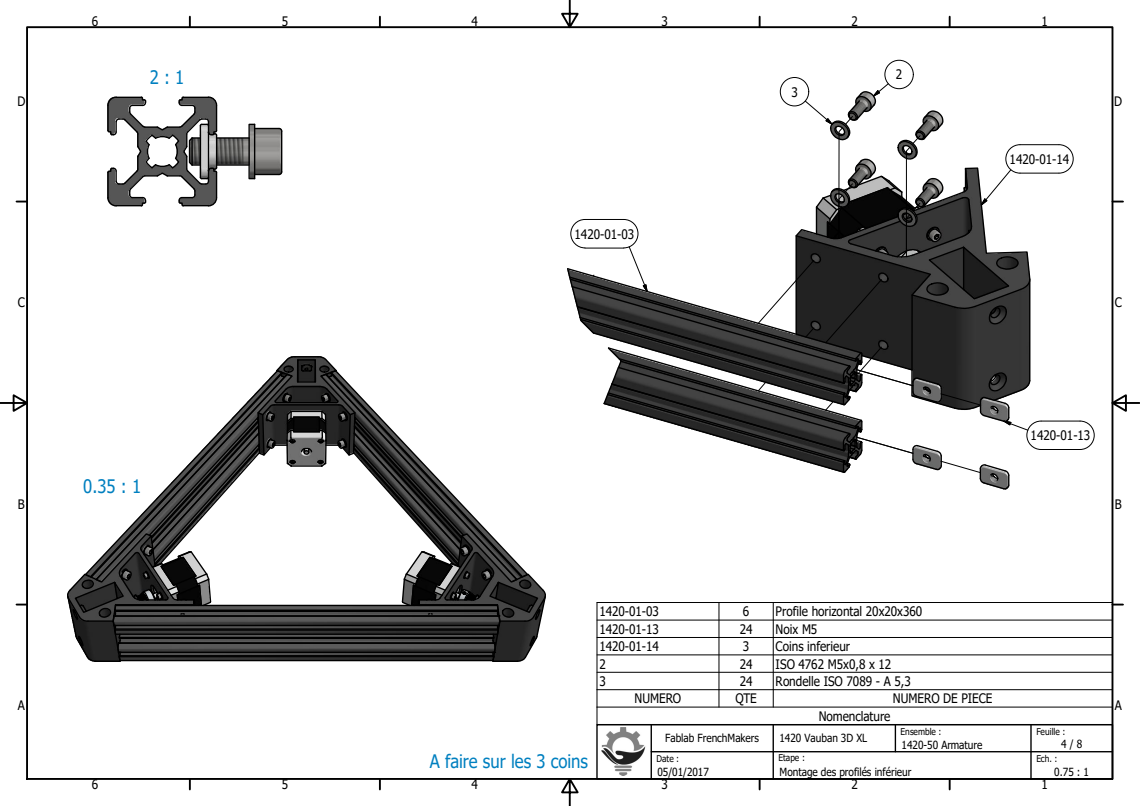
[picture p29: page 4]
Profile horizontal 20x20x360; Noix M5; Coins inferieur; ISO 4762 M5x0,8 x 12; Rondelle ISO 7089 - A 5,3; Nomenclature; NUMERO; QTE; NUMERO DE PIECE; Feuille :; Ensemble :

A faire sur les 3 coins

Montage des profilps infprieur

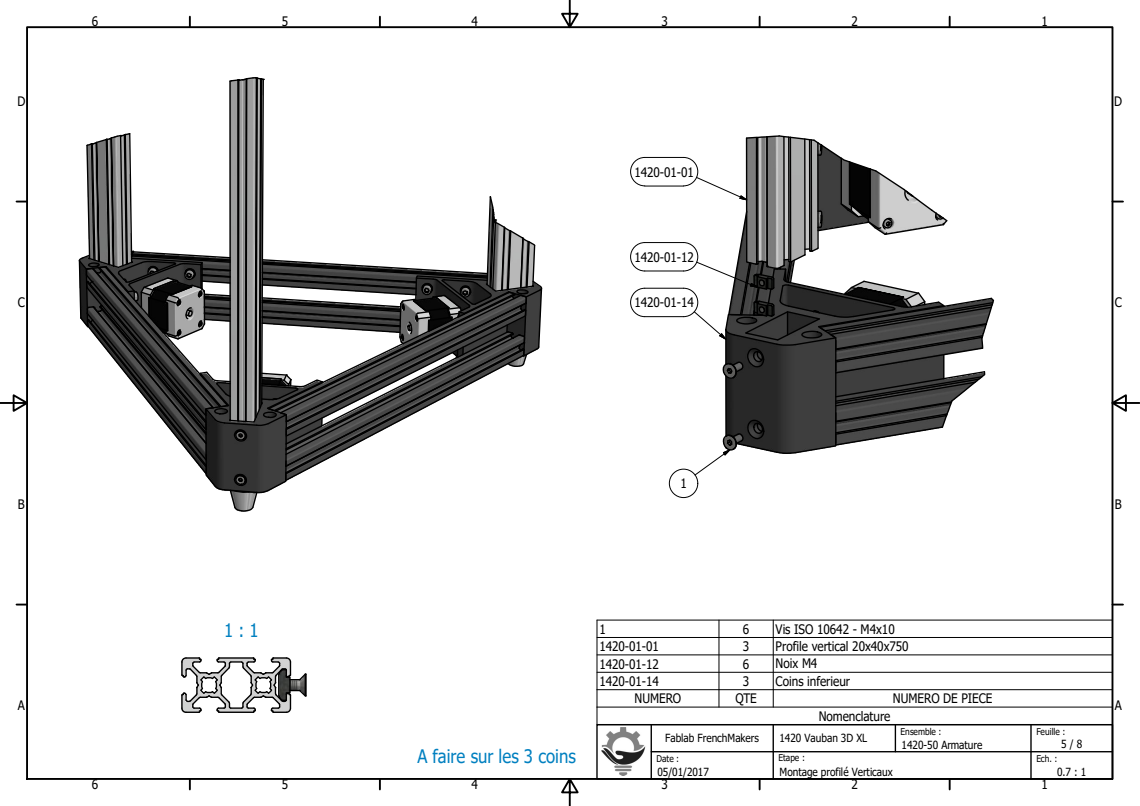
[picture p30: page 5]
Vis ISO 10642 - M4x10; Profile vertical 20x40x750; Noix M4; Coins inferieur; Nomenclature; NUMERO; QTE; NUMERO DE PIECE; Feuille :; Ensemble :

A faire sur les 3 coins

Montage profilp Verticaux

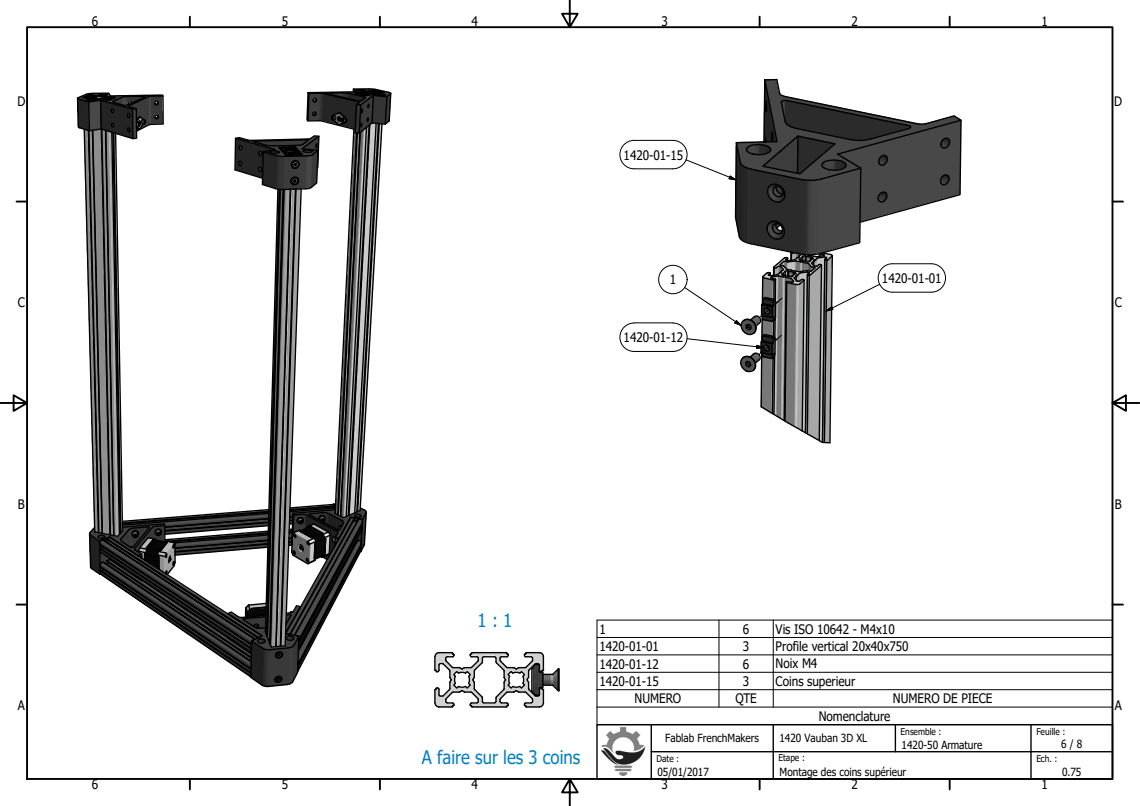
[picture p31: page 6]
Vis ISO 10642 - M4x10; Profile vertical 20x40x750; Noix M4; Coins superieur; Nomenclature; NUMERO; QTE; NUMERO DE PIECE; Feuille :; Ensemble :

A faire sur les 3 coins

Montage des coins supprieur

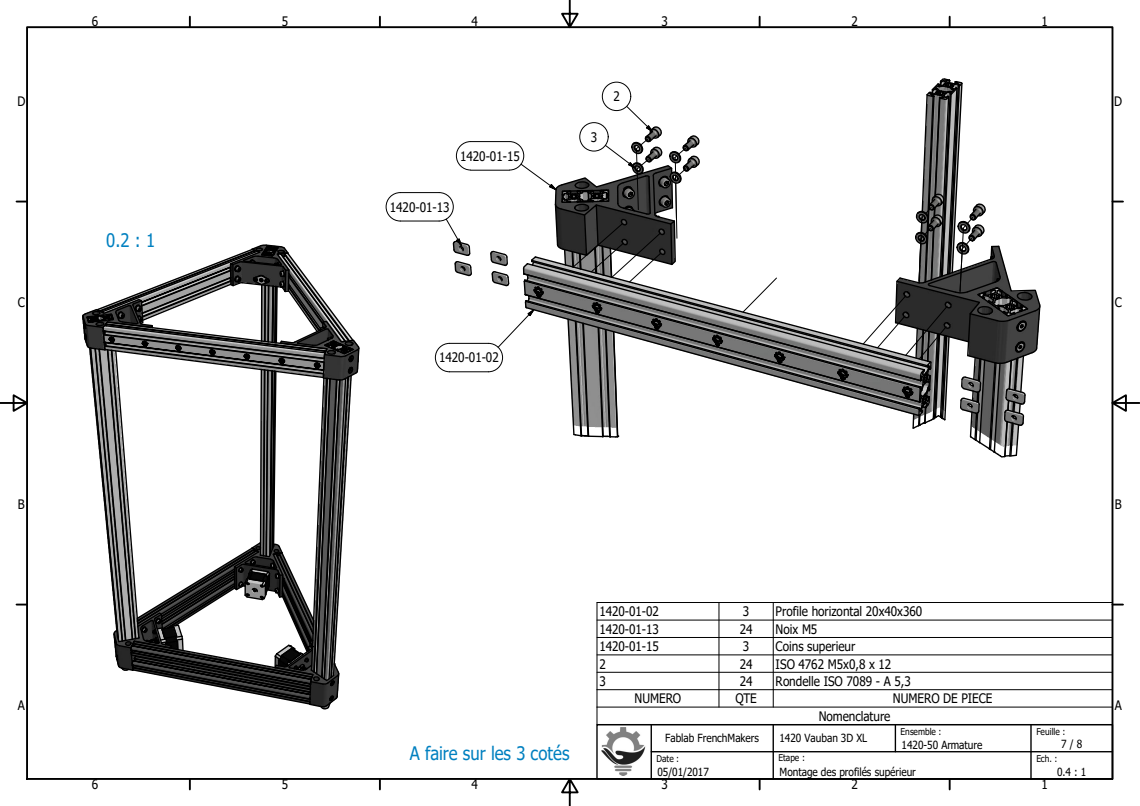
[picture p32: page 7]
Profile horizontal 20x40x360; Noix M5; Coins superieur; ISO 4762 M5x0,8 x 12; Rondelle ISO 7089 - A 5,3; Nomenclature; NUMERO; QTE; NUMERO DE PIECE; Feuille :; Ensemble :

A faire sur les 3 cotps

Montage des profilps supprieur

0.75 : 1

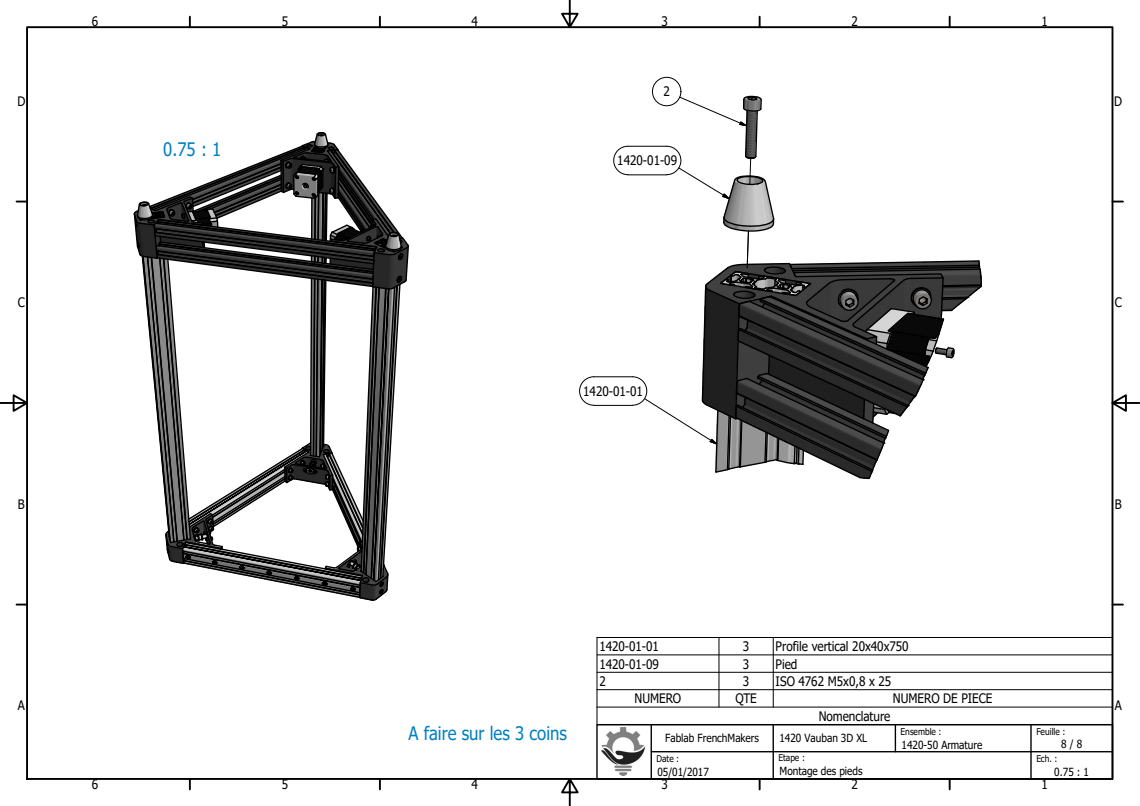
[picture p33: page 8]
Profile vertical 20x40x750; Pied; ISO 4762 M5x0,8 x 25; Nomenclature; NUMERO; QTE; NUMERO DE PIECE; Feuille :; Ensemble :

A faire sur les 3 coins

Montage des pieds
