frenchmakers/vauban3d-xl/1420 Notice de montage/1420-52 Electronique/1420-52 Electronique.pdf

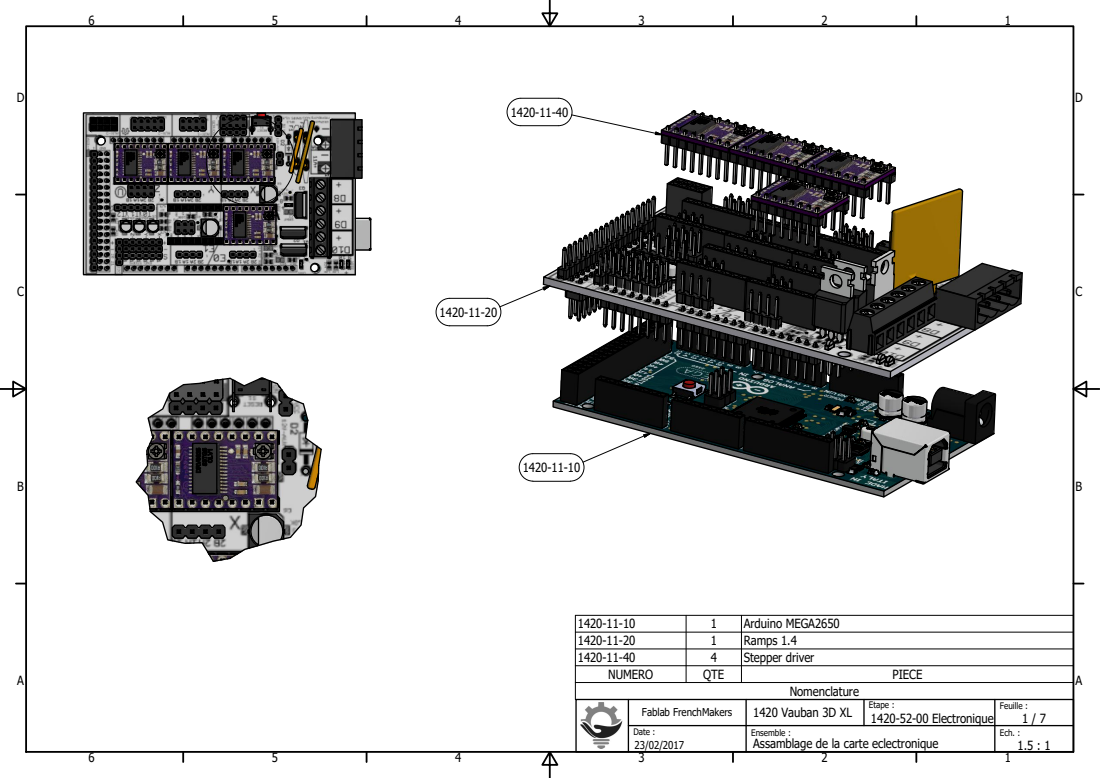
[picture p34: page 1]
Arduino MEGA2650; Ramps 1.4; Stepper driver; Nomenclature; NUMERO; QTE; PIECE; 1420 Vauban 3D XL; Ech. : 1.5 : 1; Feuille :; Fablab FrenchMakers; Date :; Etape : 1420-52-00 Electronique

Ensemble :
Assamblage de la carte eclectronique

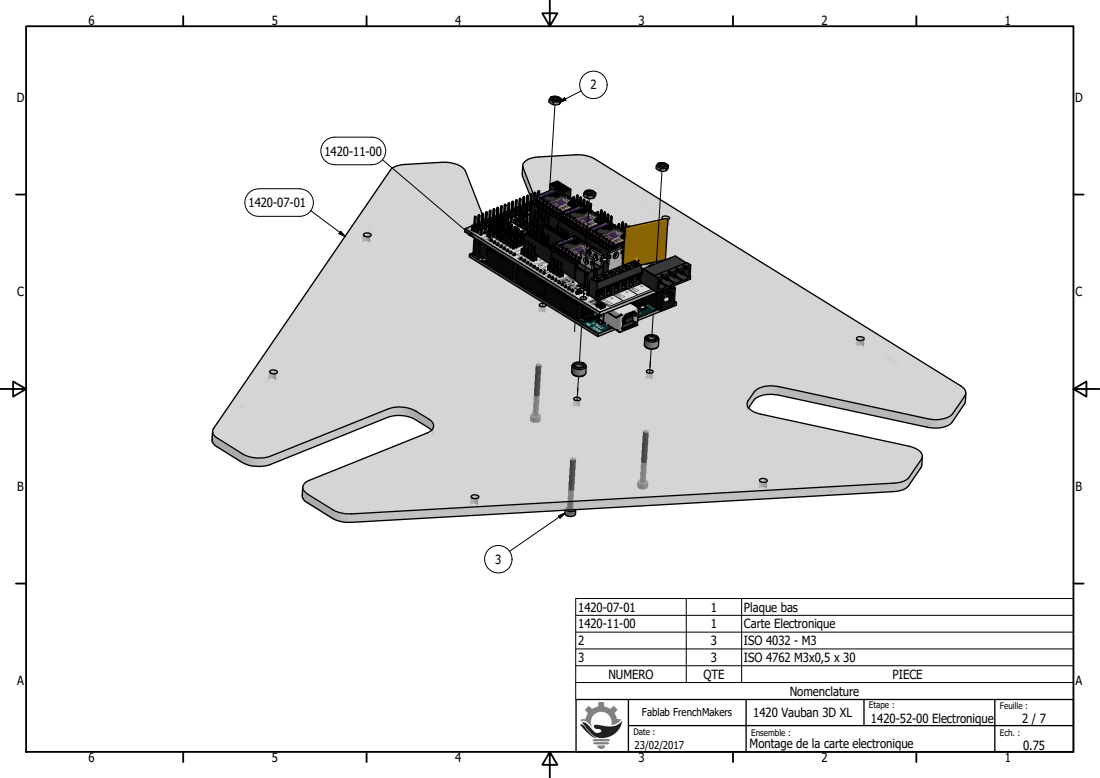
[picture p35: page 2]
Plaque bas; Carte Electronique; ISO 4032 - M3; ISO 4762 M3x0,5 x 30; Nomenclature; NUMERO; QTE; PIECE; 1420 Vauban 3D XL; Feuille :; Etape :

Montage de la carte electronique

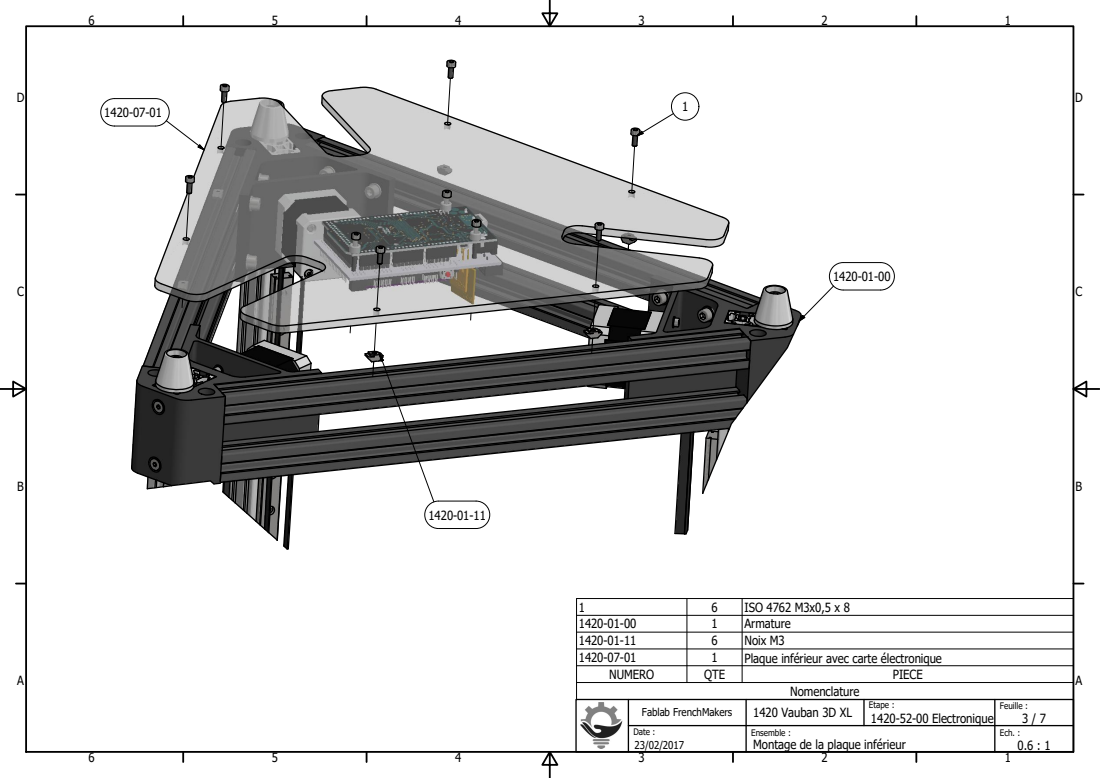
[picture p36: page 3]
ISO 4762 M3x0,5 x 8; Armature; Noix M3; Plaque infprieur avec carte plectronique; Nomenclature; NUMERO; QTE; PIECE; 1420 Vauban 3D XL; Feuille :; Etape :

Montage de la plaque infprieur

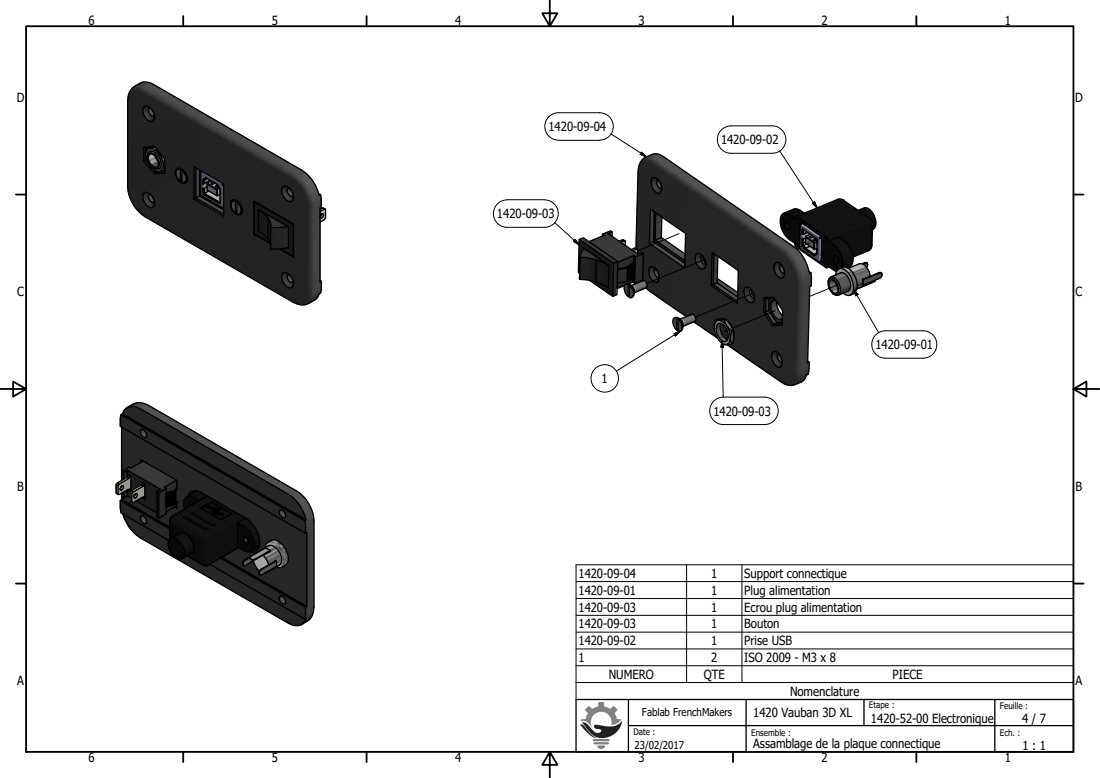
[picture p37: page 4]
Support connectique; Plug alimentation; Ecrou plug alimentation; Bouton; Prise USB; ISO 2009 - M3 x 8; Nomenclature; NUMERO; QTE; PIECE; 1420 Vauban 3D XL; Feuille :; Etape :

Assamblage de la plaque connectique

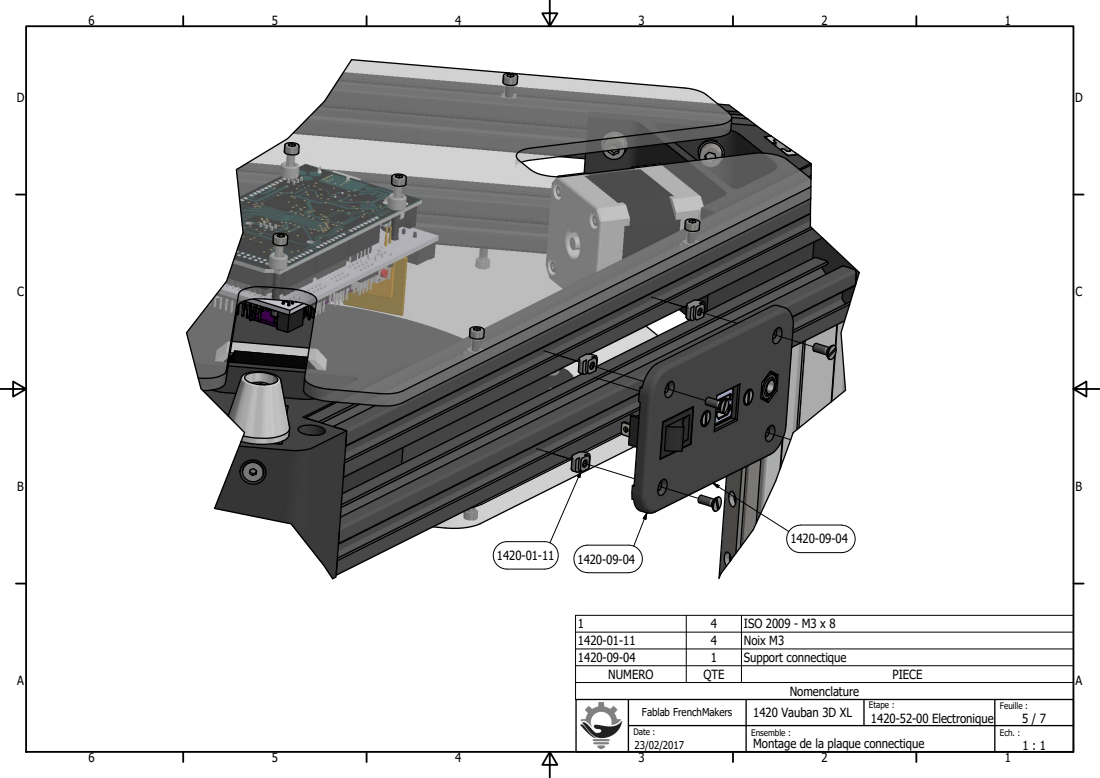
[picture p38: page 5]
ISO 2009 - M3 x 8; Noix M3; Support connectique; Nomenclature; NUMERO; QTE; PIECE; 1420 Vauban 3D XL; Feuille :; Etape :

Montage de la plaque connectique

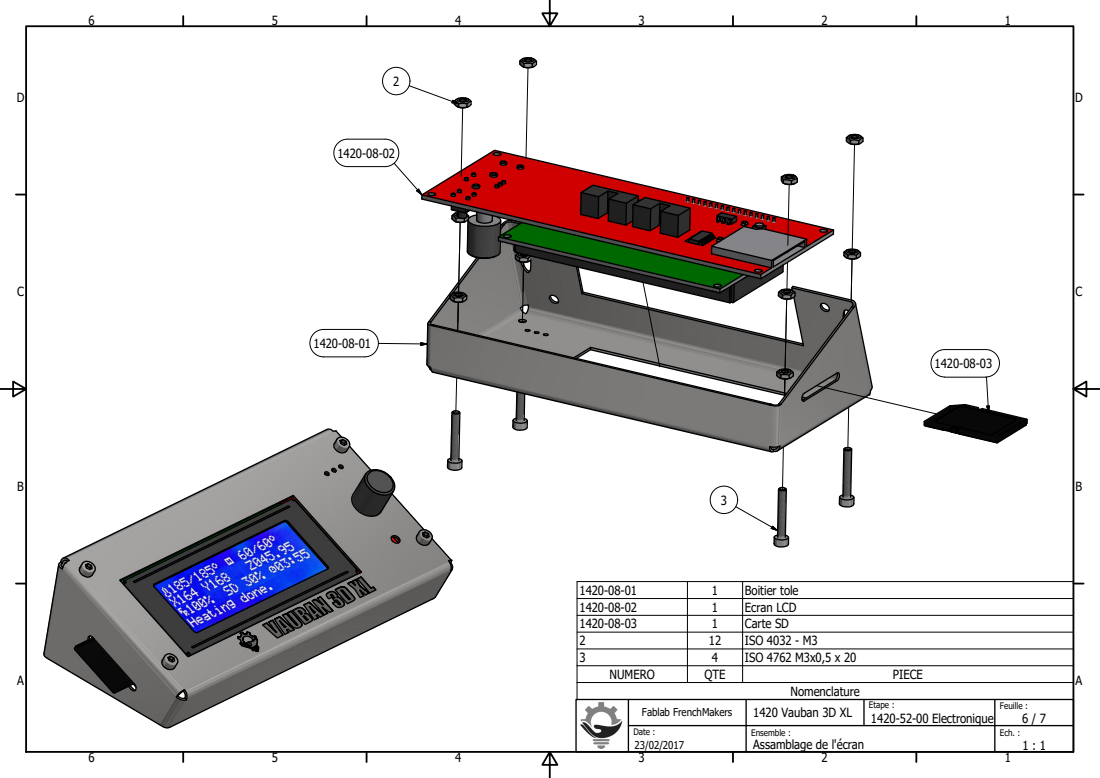
[picture p39: page 6]
Boitier tole; Ecran LCD; Carte SD; ISO 4032 - M3; ISO 4762 M3x0,5 x 20; Nomenclature; NUMERO; QTE; PIECE; 1420 Vauban 3D XL; Feuille :; Etape :

Assamblage de l'pcran

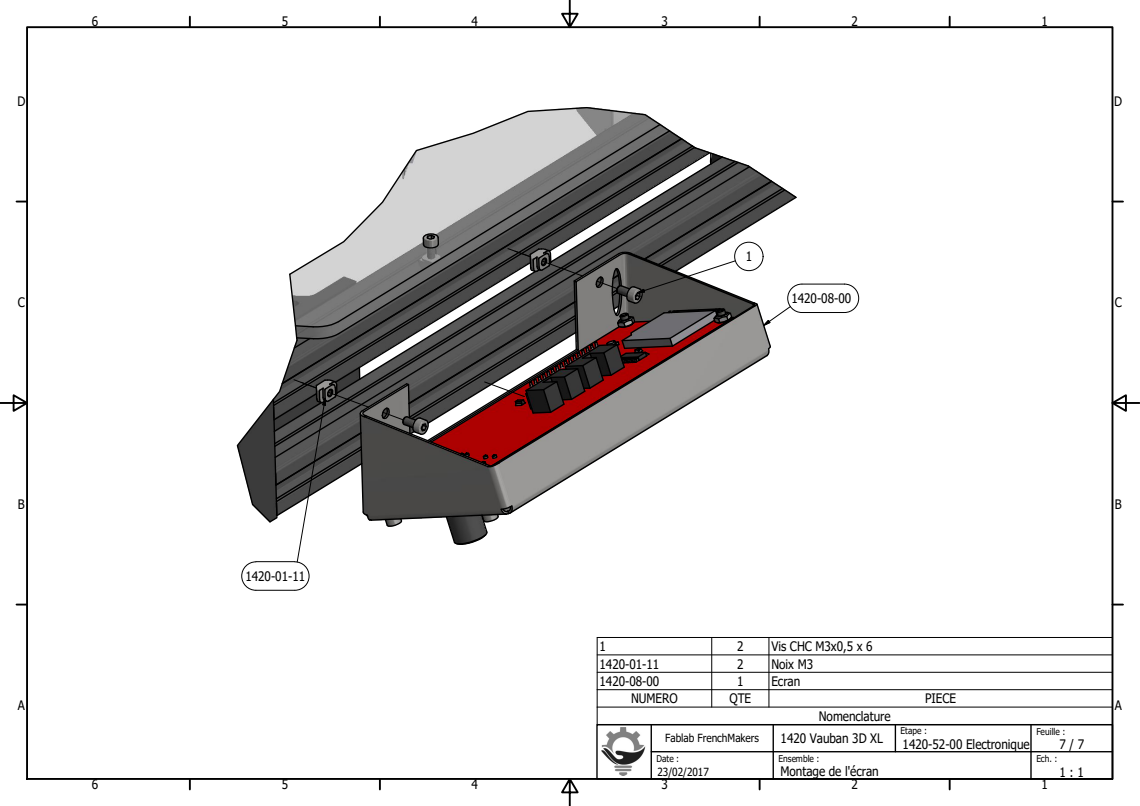
[picture p40: page 7]
Vis CHC M3x0,5 x 6; Noix M3; Ecran; Nomenclature; NUMERO; QTE; PIECE; 1420 Vauban 3D XL; Feuille :; Etape :

Montage de l'pcran
