frenchmakers/vauban3d-xl/1420 Notice de montage/1420-55 Tete/1420-55 Tete.pdf

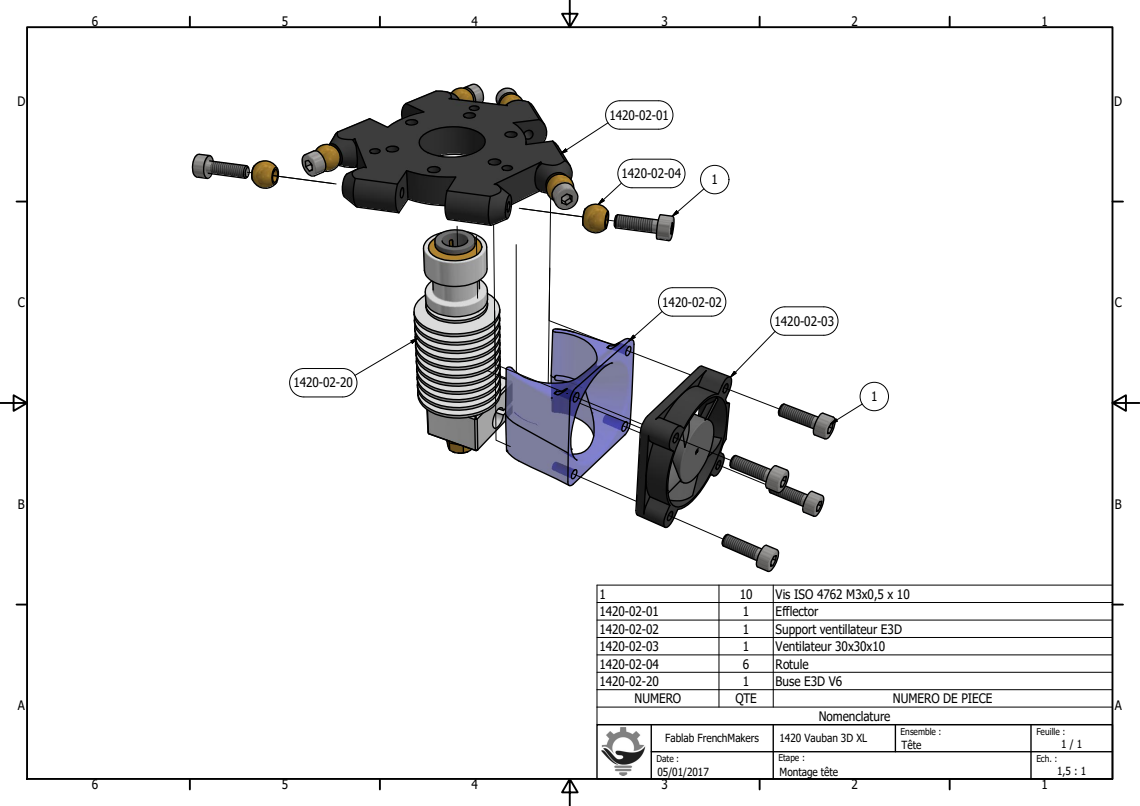
[picture p41: page 1]
Vis ISO 4762 M3x0,5 x 10; Efflector; Support ventillateur E3D; Ventilateur 30x30x10; Rotule; Buse E3D V6; Nomenclature; NUMERO; QTE; NUMERO DE PIECE; 1420 Vauban 3D XL; Ech. : 1,5 : 1; Feuille : 1 / 1; Fablab FrenchMakers; Date : 05/01/2017; Etape : Montage trte; Ensemble : Trte
