frenchmakers/vauban3d-xl/1420 Notice de montage/1420-57 Finition/1420-57 Finiton.pdf

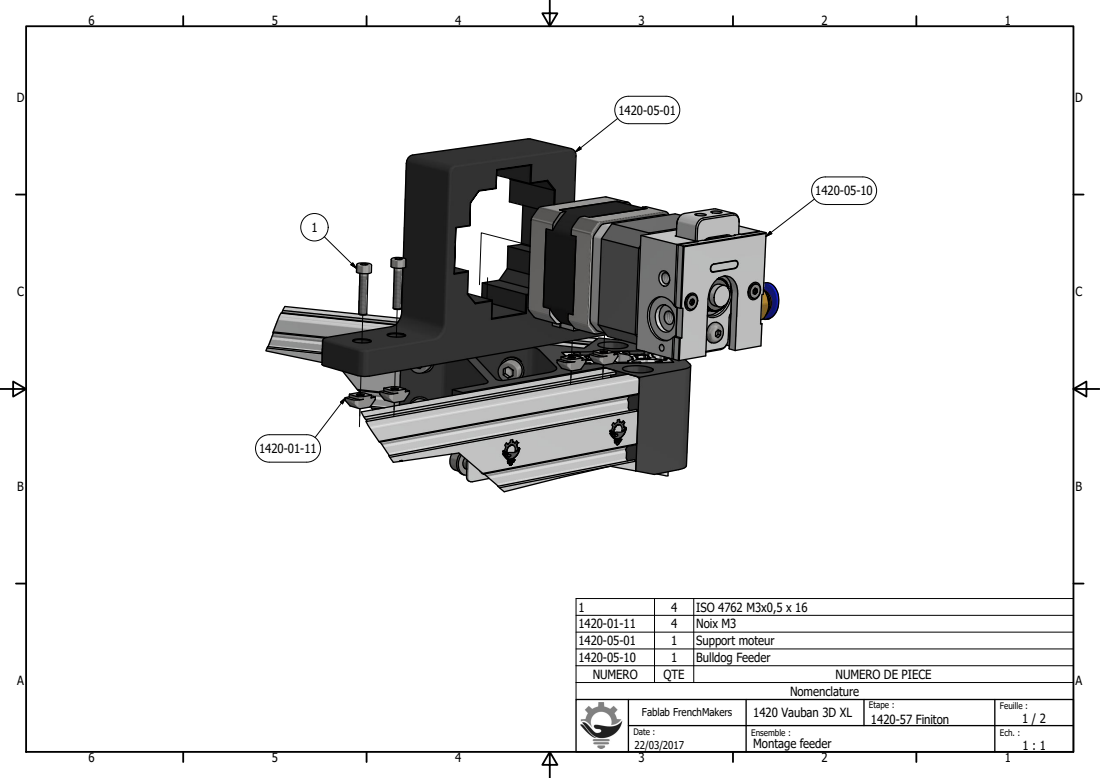
[picture p42: page 1]
ISO 4762 M3x0,5 x 16; Noix M3; Support moteur; Bulldog Feeder; Nomenclature; NUMERO; QTE; NUMERO DE PIECE; 1420 Vauban 3D XL; Ech. :; Feuille : 1 / 2; Fablab FrenchMakers; Date : 22/03/2017; Etape : 1420-57 Finiton; Ensemble : Montage feeder

1 : 1

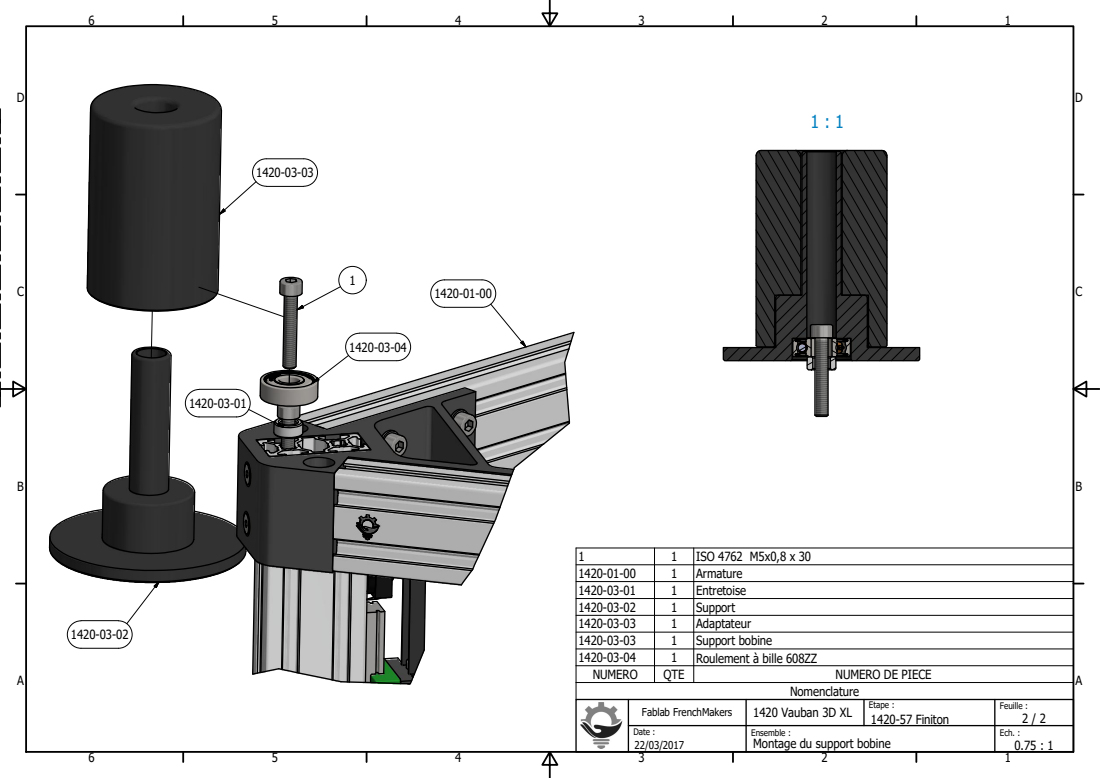
[picture p43: page 2]
ISO 4762 M5x0,8 x 30; Armature; Entretoise; Support; Adaptateur; Support bobine; Roulement j bille 608ZZ; Nomenclature; NUMERO; QTE; NUMERO DE PIECE; 1420 Vauban 3D XL; Ech. : 0.75 : 1; Feuille : 2 / 2; Fablab FrenchMakers; Date : 22/03/2017; Etape : 1420-57 Finiton

Ensemble :
Montage du support bobine
